akita11/BLE_PresenPointer/README.md

# BLEプレゼンポインター 関連ファイル

by akita11(akita@ifdl.jp)

## ファイル・フォルダ構成

* board: 基板データ
* src: ソースコード(PSoC Creator4.0用: TPT02rを使ってください)
* BLE_PresenterModule_v150.pdf (組み立て手順、使い方）
* BLE_PresenterModule_v150_digest.pdf (マニュアル要約：製品同梱）
