akita11/BLE_PresenPointer/board/BLE_PP_v16_BOM.xlsx

BOM for TPT02
Elecrow PN | Parts | Value | Package | QTY | Digikey/Mouser/Manufacturer Part | Remark/ Link
2014210A | C1,C2 | 10u | C0603 | 2
4040806A | D1 | LED, blue | C0603 | 1
 | L1 | 4.7uH | C2016 | 1 | 732-2956-1-ND | Wurth, 74479776247
C22775 | R1 | 100ohm | C0603 | 1
C23150 | R2 | 390kohm | C0603 | 1
C25803 | R3 | 100kohm | C0603 | 1
 | SW1 | EVQ-P2T02W |  | 1 | P11083SCT-ND | Panasonic, EVQ-P2T02W
 | SW2,SW3 | EVQ-PLFA08 |  | 2 | P12275SCT-ND | Panasonic, EVQ-PLFA08
 | SW4 | CUS-12TB |  | 1 | 563-1102-1-ND | Copal, CUS-12TB
 | SW5 | EVQP7A01P |  | 1 | P16763CT-ND | Panasonic, EVQP7A01P
 | U1 | CYBLE-014008-00 |  | 1 | 428-3600-1-ND | Cypress, CYBLE-014008-00
 | U2 | TPS61221DCKR |  | 1 | 296-41854-1-ND | TI, TPS61221DCKR
