akita11/BLE_PresenPointer/board/work/TPT02_v12_BOM.xlsx

BOM Example
Elecrow PN | Parts | Value | Package | QTY | Digikey/Mouser/Manufacturer Part | Remark/ Link
2014210A | C1,C2 | 10u | C0603 | 2
4040806A | D1 | LED, blue | C0603 | 1
 | L1 | 4.7uF | C2016 | 1 | 732-2954-1-ND | Wurth, 74479776222
1023510A | R1 | 10k | C0603 | 1
 | SW1 | EVQ-P2R02M |  | 1 | P12292SCT-ND | Panasonic, EVQ-P2R02M
 | SW2,SW3 | EVQ-PLFA08 |  | 2 | P12275SCT-ND | Panasonic, EVQ-PLFA08
 | SW4 | CUS-12TB |  | 1 | 563-1102-1-ND | Copal, CUS-12TB
 | SW5 | B3U-3000P |  | 1 | SW1022CT-ND | Omron, B3U-3000P
 | U1 | CYBLE-014008-00 |  | 1 | 428-3600-1-ND | Cypress, CYBLE-014008-00
 | U2 | TPS61221DCKR |  | 1 | 296-41854-1-ND | TI, TPS61221DCKR
