akita11/BLE_PresenPointer/(list of files, cad)

Other CAD files:
board/work/TPT02_v142-tcream.dxf
board/work/TPT02_v14-tcream.dxf
board/work/TPT02_v13-tcream.dxf
