akita11/BLE_PresenPointer/board/work/TPT02_PartsMapping_Component.pdf

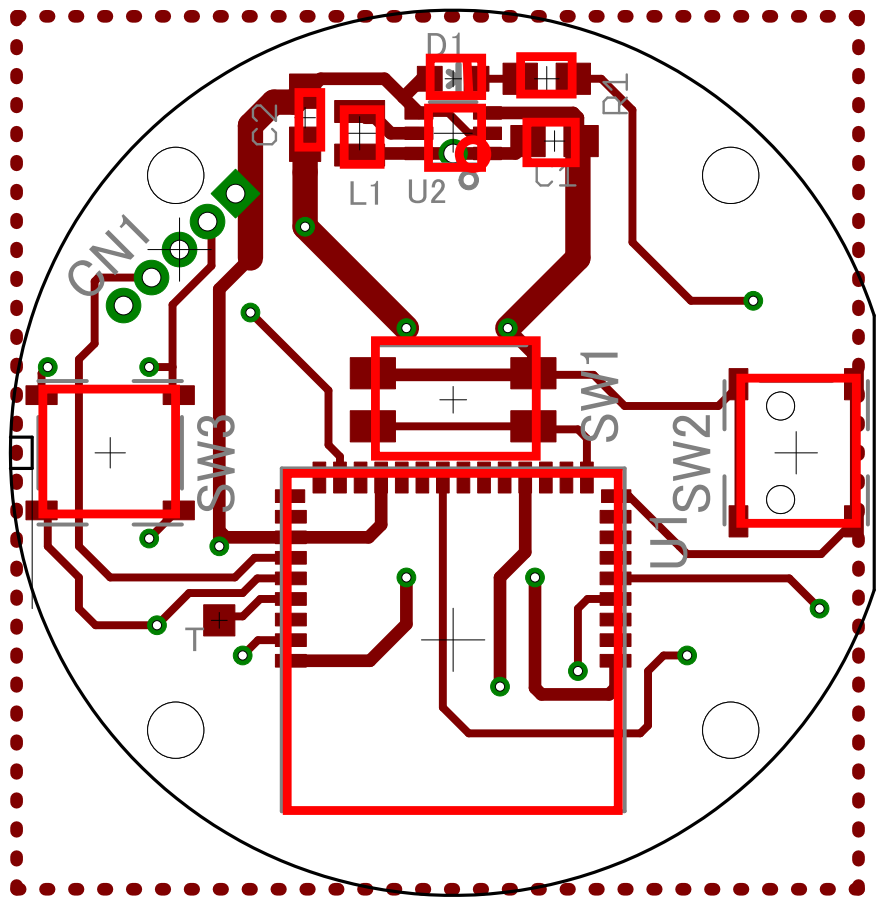
[picture p15: page 1]
