akita11/BLE_PresenPointer/board/work/TPT02_PartsMapping_Solder.pdf

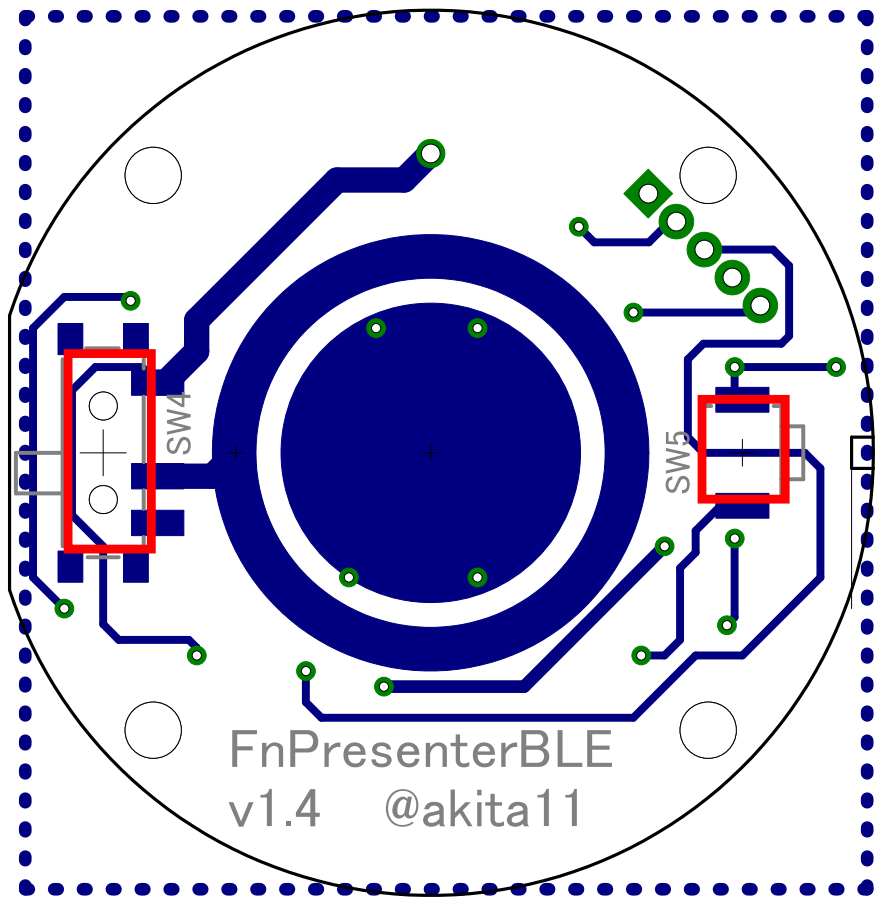
[picture p16: page 1]
