akita11/BLE_PresenPointer/BLE_PresenterModule_v150_digest.pdf

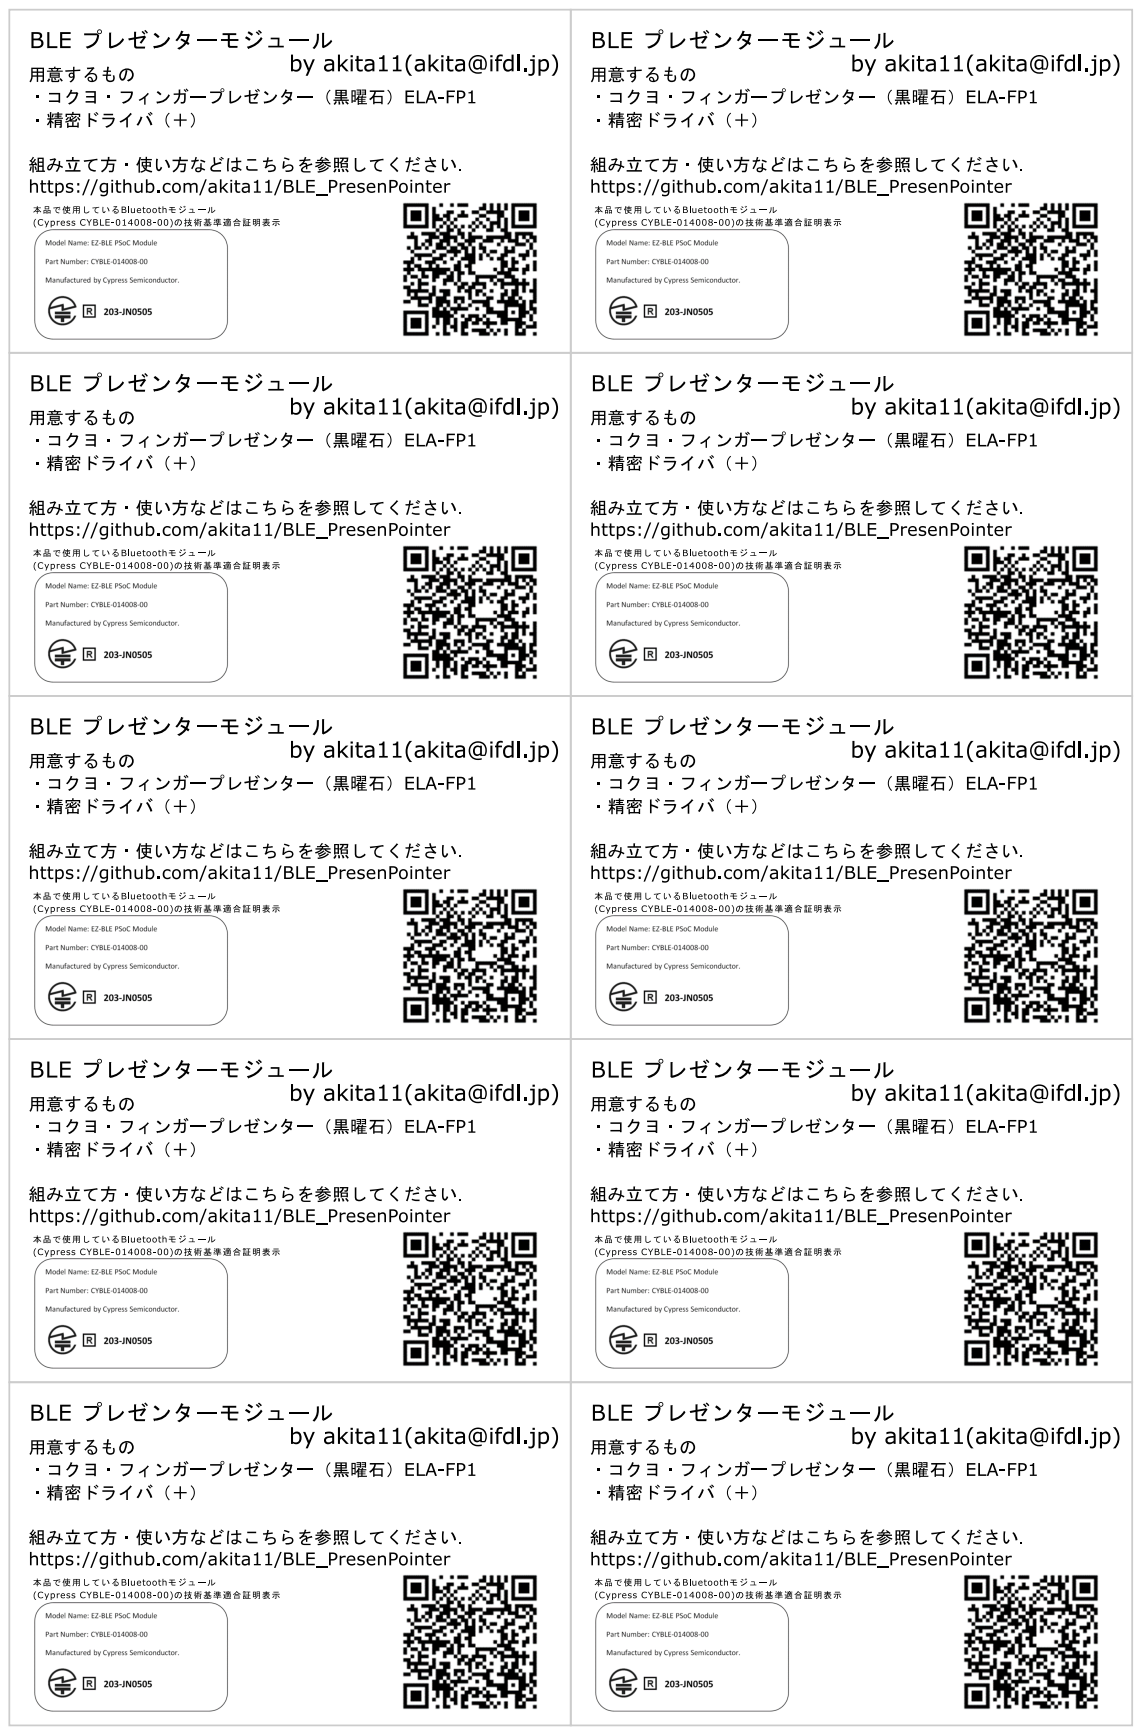
[picture p17: page 1]
