akita11/BLE_PresenPointer/board/BLE_PP_v16.brd

## EAGLE design board/BLE_PP_v16.brd (2017-04-21)

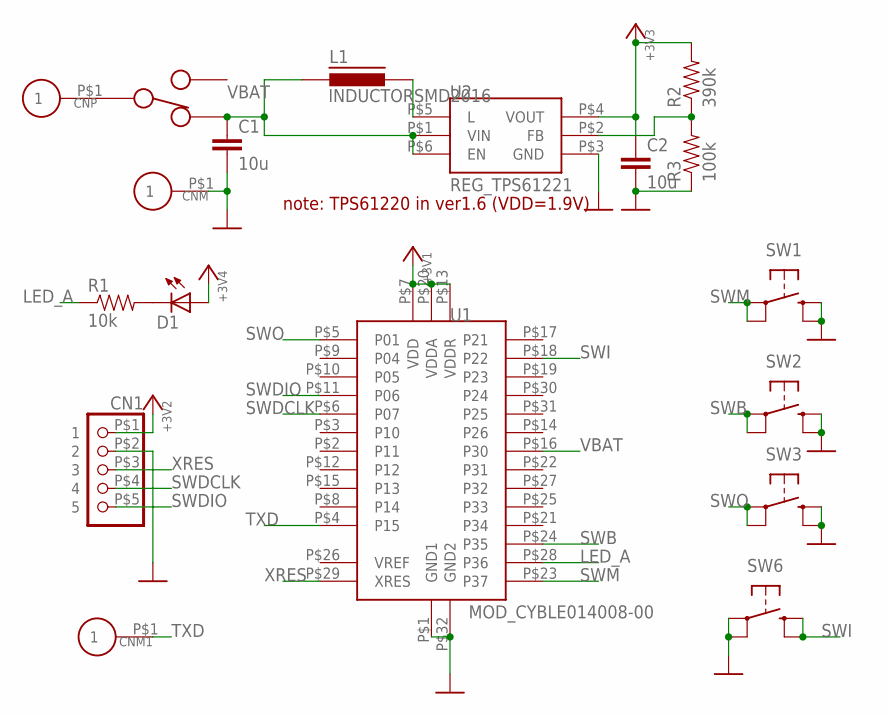
[picture p18: schematic BLE_PP_v16.sch]

Parts:
C1, C2: 10u; 0603
CN1: CON_PINHD-1X550MIL; 1X5_50MIL
CNM, CNM1: CON_P01SMD1MM; PAD_SMD1MM
CNP: CON_P01SMD1MM; PAD_SMD1MM
D1: LED0603; SPARKFUN_LED-0603
L1: INDUCTORSMD2016; 2016
R1: 10k; 0603
R2: 390k; 0603
R3: 100k; 0603
SW1: SW_TACTEVQP2; SW_EVQP2
SW2, SW3: SW_TACTEVQPLNA08NOGND; SW_EVQPLBA08_NOGND
SW4: SW_SLIDECUS12B; SW_CUS-12B
SW6: SW_TACTEVQP7; SW_EVQP7
U1: MOD_CYBLE014008-00
U2: REG_TPS61221; SC70-6

Connections:
+3V3: C2.1, CN1.P$1 (1), D1.A, R2.2, U1.P$7 (VDD), U1.P$13 (VDDR), U1.P$20 (VDDA), U2.P$4 (VOUT)
GND: C1.2, C2.2, CN1.P$2 (2), CNM.P$1, R3.1, SW1.PB1 (S), SW1.PB2 (S1), SW2.B1 (S), SW2.B2 (S1), SW3.B1 (S), SW3.B2 (S1), SW6.P$1A, SW6.P$1B (P1), U1.P$1 (GND1), U1.P$32 (GND2), U2.P$3 (GND)
LED_A: R1.1, U1.P$28 (P36)
unnamed: R2.1, R3.2, U2.P$2 (FB)
unnamed: L1.P$2 (2), U2.P$5 (L)
unnamed: D1.C, R1.2
unnamed: CNP.P$1, SW4.P$2
P$3: SW4.P$3
SWB: SW2.A1, SW2.A2 (P1), U1.P$24 (P35)
SWDCLK: CN1.P$4 (4), U1.P$6 (P07)
SWDIO: CN1.P$5 (5), U1.P$11 (P06)
SWI: SW6.P$2A (S), SW6.P$2B (S1), U1.P$18 (P22)
SWM: SW1.PA1, SW1.PA2 (P1), U1.P$23 (P37)
SWO: SW3.A1, SW3.A2 (P1), U1.P$5 (P01)
TXD: CNM1.P$1, U1.P$4 (P15)
VBAT: C1.1, L1.P$1 (1), SW4.P$1, U1.P$16 (P30), U2.P$1 (VIN), U2.P$6 (EN)
XRES: CN1.P$3 (3), U1.P$29 (XRES)

Notes on the sheet:
note: TPS61220 in ver1.6 (VDD=1.9V)

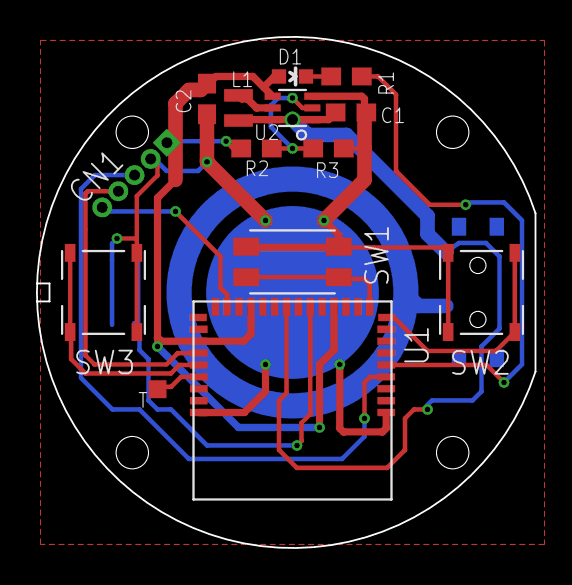
[picture p19: board BLE_PP_v16.brd from above]

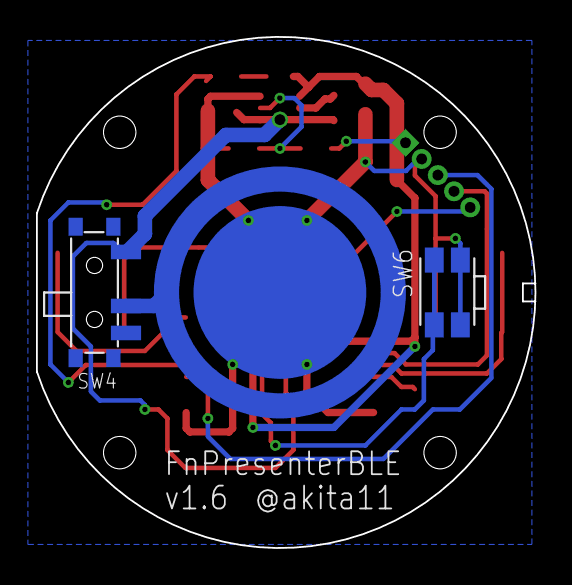
[picture p20: board BLE_PP_v16.brd from below]

Board: 2 copper layers, 27.7 x 28.4 mm, 18 parts (4 on the bottom side), 16 nets.
