akita11/BLE_PresenPointer/board/work/TPT02_tentative.brd

## EAGLE design board/work/TPT02_tentative.brd (2016-12-26)

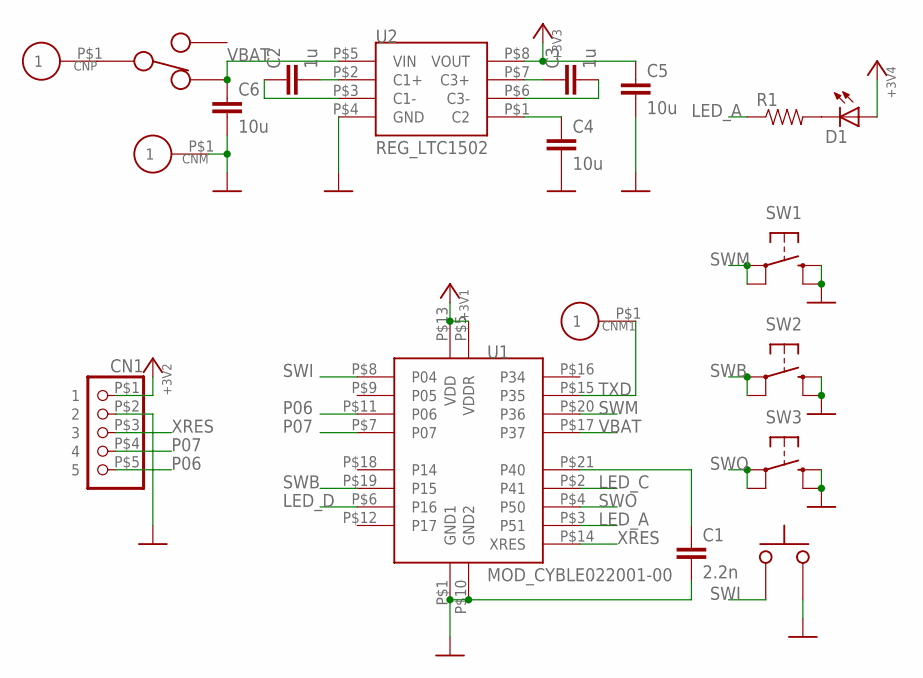
[picture p21: schematic TPT02_tentative.sch]

Parts:
C1: 2.2n; 0603
C2, C3: 1u; 0603
C4, C5, C6: 10u; 0603
CN1: CON_PINHD-1X550MIL; 1X5_50MIL
CNM, CNM1: CON_P01SMD1MM; PAD_SMD1MM
CNP: CON_P01SMD1MM; PAD_SMD1MM
D1: LED0603; SPARKFUN_LED-0603
R1: RES0603; 0603
SW1: SW_TACTEVQP2; SW_EVQP2
SW2, SW3: SW_TACTTVAF17; SW_TVF17
SW4: SW_SLIDECUS12; SW_CUS-12B
SW6: SW_TACT2PB3U3000; SW_B3U-3000P
U1: MOD_CYBLE022001-00
U2: REG_LTC1502; MSOP8

Connections:
+3V3: C5.1, CN1.P$1 (1), D1.A, U1.P$5 (VDDR), U1.P$13 (VDD), U2.P$8 (VOUT)
GND: C1.2, C4.2, C5.2, C6.2, CN1.P$2 (2), CNM.P$1, SW1.PB1 (S), SW1.PB2 (S1), SW2.P$3 (S), SW2.P$4 (S1), SW3.P$3 (S), SW3.P$4 (S1), SW6.P$1, U1.P$1 (GND1), U1.P$10 (GND2), U2.P$4 (GND)
LED_A: R1.1, U1.P$3 (P51)
LED_C: U1.P$2 (P41)
LED_D: U1.P$6 (P16)
unnamed: C1.1, U1.P$21 (P40)
unnamed: C4.1, U2.P$1 (C2)
unnamed: C2.2, U2.P$2 (C1+)
unnamed: C2.1, U2.P$3 (C1-)
unnamed: C3.1, U2.P$7 (C3+)
unnamed: C3.2, U2.P$6 (C3-)
unnamed: D1.C, R1.2
unnamed: CNP.P$1, SW4.P$2
P06: CN1.P$5 (5), U1.P$11 (P06)
P07: CN1.P$4 (4), U1.P$7 (P07)
P$3: SW4.P$3
SWB: SW2.P$1, SW2.P$2 (P1), U1.P$19 (P15)
SWI: SW6.P$2, U1.P$8 (P04)
SWM: SW1.PA1, SW1.PA2 (P1), U1.P$20 (P36)
SWO: SW3.P$1, SW3.P$2 (P1), U1.P$4 (P50)
TXD: CNM1.P$1, U1.P$15 (P35)
VBAT: C6.1, SW4.P$1, U1.P$17 (P37), U2.P$5 (VIN)
XRES: CN1.P$3 (3), U1.P$14 (XRES)

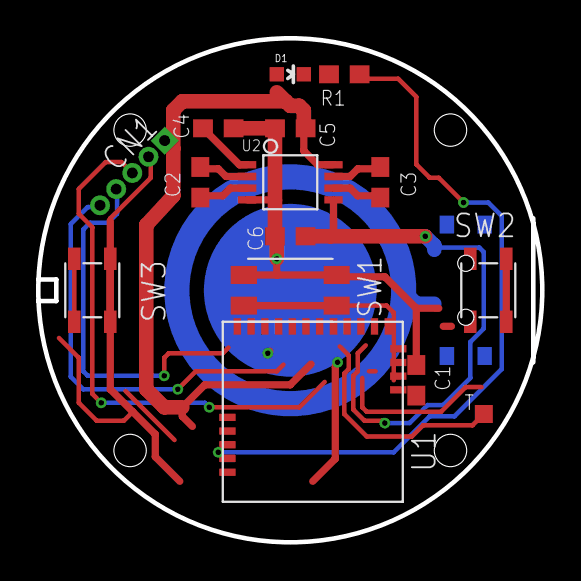
[picture p22: board TPT02_tentative.brd from above]

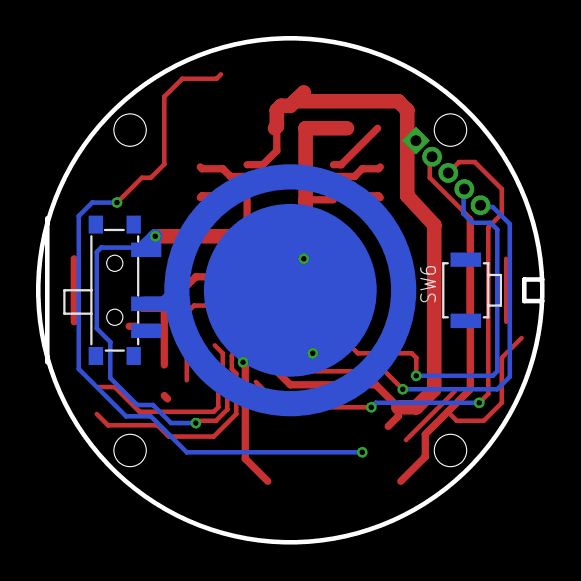
[picture p23: board TPT02_tentative.brd from below]

Board: 2 copper layers, 28.0 x 28.0 mm, 19 parts (4 on the bottom side), 20 nets.
