akita11/BLE_PresenPointer/src/TPT02r.cydsn/main.c

// BLE Presenter Module Firmware v1.5
//   Based on Cypress PSoC Creator (4.0), BLE-HID sample project
//   (c) Junichi Akita (akita@ifdl.jp), 2017/4/20

/*******************************************************************************
* File Name: main.c
*
* Version: 1.0
*
* Description:
*  BLE HID keyboard example project that supports both input and output reports
*  in boot and protocol mode. The example also demonstrates handling suspend 
*  event from the central device and enters low power mode when suspended.
*
* References:
*  BLUETOOTH SPECIFICATION Version 4.1
*  HID Usage Tables spec ver 1.12
*
* Hardware Dependency:
*  CY8CKIT-042 BLE
*
********************************************************************************
* Copyright 2015, Cypress Semiconductor Corporation.  All rights reserved.
* You may use this file only in accordance with the license, terms, conditions,
* disclaimers, and limitations in the end user license agreement accompanying
* the software package with which this file was provided.
*******************************************************************************/

#include "common.h"
#include "hids.h"
#include "bas.h"
#include "scps.h"

volatile uint32 mainTimer = 0;

volatile uint16_t Ton = 0;
volatile uint16_t Tconnect = 0;
uint8_t fUpdated = 0;

CY_ISR(SWID_Handler)
{
    /* Clear pending Interrupt */
    Wakeup_Interrupt_ClearPending();

    /* Clear pin Interrupt */
    SWID_ClearInterrupt();
//    DBG_PRINTF("ID\r\n");
}


/*******************************************************************************
* Function Name: AppCallBack()
********************************************************************************
*
* Summary:
*   This is an event callback function to receive events from the BLE Component.
*
*******************************************************************************/
void AppCallBack(uint32 event, void* eventParam)
{
    CYBLE_API_RESULT_T apiResult;
    CYBLE_GAP_BD_ADDR_T localAddr;
    CYBLE_GAP_AUTH_INFO_T *authInfo;
    uint8 i;
    
    switch (event)
	{
        /**********************************************************
        *                       General Events
        ***********************************************************/
		case CYBLE_EVT_STACK_ON: /* This event is received when the component is Started */
            /* Enter into discoverable mode so that remote can search it. */
            apiResult = CyBle_GappStartAdvertisement(CYBLE_ADVERTISING_FAST);
            if(apiResult != CYBLE_ERROR_OK)
            {
                DBG_PRINTF("StartAdvertisement API Error: %d \r\n", apiResult);
            }
            DBG_PRINTF("Bluetooth On, StartAdvertisement with addr: ");
            localAddr.type = 0u;
            CyBle_GetDeviceAddress(&localAddr);
            for(i = CYBLE_GAP_BD_ADDR_SIZE; i > 0u; i--)
            {
                DBG_PRINTF("%2.2x", localAddr.bdAddr[i-1]);
            }
            DBG_PRINTF("\r\n");
            break;
		case CYBLE_EVT_TIMEOUT: 
            break;
		case CYBLE_EVT_HARDWARE_ERROR:    /* This event indicates that some internal HW error has occurred. */
            DBG_PRINTF("CYBLE_EVT_HARDWARE_ERROR \r\n");
			break;
            
    	/* This event will be triggered by host stack if BLE stack is busy or not busy.
    	 *  Parameter corresponding to this event will be the state of BLE stack.
    	 *  BLE stack busy = CYBLE_STACK_STATE_BUSY,
    	 *  BLE stack not busy = CYBLE_STACK_STATE_FREE 
         */
    	case CYBLE_EVT_STACK_BUSY_STATUS:
            DBG_PRINTF("CYBLE_EVT_STACK_BUSY_STATUS: %x\r\n", *(uint8 *)eventParam);
            break;
        case CYBLE_EVT_HCI_STATUS:
            DBG_PRINTF("CYBLE_EVT_HCI_STATUS: %x \r\n", *(uint8 *)eventParam);
			break;
            
        /**********************************************************
        *                       GAP Events
        ***********************************************************/
        case CYBLE_EVT_GAP_AUTH_REQ:
            DBG_PRINTF("CYBLE_EVT_AUTH_REQ: security=%x, bonding=%x, ekeySize=%x, err=%x \r\n", 
                (*(CYBLE_GAP_AUTH_INFO_T *)eventParam).security, 
                (*(CYBLE_GAP_AUTH_INFO_T *)eventParam).bonding, 
                (*(CYBLE_GAP_AUTH_INFO_T *)eventParam).ekeySize, 
                (*(CYBLE_GAP_AUTH_INFO_T *)eventParam).authErr);
            break;
        case CYBLE_EVT_GAP_PASSKEY_ENTRY_REQUEST:
            DBG_PRINTF("CYBLE_EVT_PASSKEY_ENTRY_REQUEST press 'p' to enter passkey \r\n");
            break;
        case CYBLE_EVT_GAP_PASSKEY_DISPLAY_REQUEST:
            DBG_PRINTF("CYBLE_EVT_PASSKEY_DISPLAY_REQUEST %6.6ld \r\n", *(uint32 *)eventParam);
            break;
        case CYBLE_EVT_GAP_KEYINFO_EXCHNGE_CMPLT:
            DBG_PRINTF("CYBLE_EVT_GAP_KEYINFO_EXCHNGE_CMPLT \r\n");
            break;
        case CYBLE_EVT_GAP_AUTH_COMPLETE:
            authInfo = (CYBLE_GAP_AUTH_INFO_T *)eventParam;
            (void)authInfo;
            DBG_PRINTF("AUTH_COMPLETE: security:%x, bonding:%x, ekeySize:%x, authErr %x \r\n", 
                                    authInfo->security, authInfo->bonding, authInfo->ekeySize, authInfo->authErr);
            break;
        case CYBLE_EVT_GAP_AUTH_FAILED:
            DBG_PRINTF("CYBLE_EVT_AUTH_FAILED: %x \r\n", *(uint8 *)eventParam);
            break;
        case CYBLE_EVT_GAPP_ADVERTISEMENT_START_STOP:
            DBG_PRINTF("CYBLE_EVT_ADVERTISING, state: %x \r\n", CyBle_GetState());
            if(CYBLE_STATE_DISCONNECTED == CyBle_GetState())
            {   
                /* Fast and slow advertising period complete, go to low power  
                 * mode (Hibernate mode) and wait for an external
                 * user event to wake up the device again */
                DBG_PRINTF("Hibernate \r\n");
                Advertising_LED_Write(LED_OFF);
//                Disconnect_LED_Write(LED_ON);
                CapsLock_LED_Write(LED_OFF);
//                SW2_ClearInterrupt();
                Wakeup_Interrupt_ClearPending();
                Wakeup_Interrupt_Start();
            #if (DEBUG_UART_ENABLED == ENABLED)
                /* Wait until debug info is sent */
                while((UART_DEB_SpiUartGetTxBufferSize() + UART_DEB_GET_TX_FIFO_SR_VALID) != 0);
            #endif /* (DEBUG_UART_ENABLED == ENABLED) */
                CySysPmHibernate();
            }
            break;
        case CYBLE_EVT_GAP_DEVICE_CONNECTED:
            DBG_PRINTF("CYBLE_EVT_GAP_DEVICE_CONNECTED \r\n");
            int i;
            for (i = 0; i < 5; i++){
                Advertising_LED_Write(LED_ON);
                CyDelay(100);
                Advertising_LED_Write(LED_OFF);
                CyDelay(100);
            }
            Advertising_LED_Write(LED_OFF);
            break;
        case CYBLE_EVT_GAP_DEVICE_DISCONNECTED:
            DBG_PRINTF("CYBLE_EVT_GAP_DEVICE_DISCONNECTED\r\n");
            apiResult = CyBle_GappStartAdvertisement(CYBLE_ADVERTISING_FAST);
            if(apiResult != CYBLE_ERROR_OK)
            {
                DBG_PRINTF("StartAdvertisement API Error: %d \r\n", apiResult);
            }
            break;
        case CYBLE_EVT_GATTS_XCNHG_MTU_REQ:
            { 
                uint16 mtu;
                CyBle_GattGetMtuSize(&mtu);
                DBG_PRINTF("CYBLE_EVT_GATTS_XCNHG_MTU_REQ, final mtu= %d \r\n", mtu);
            }
            break;
        case CYBLE_EVT_GATTS_WRITE_REQ:
            DBG_PRINTF("CYBLE_EVT_GATT_WRITE_REQ: %x = ",((CYBLE_GATTS_WRITE_REQ_PARAM_T *)eventParam)->handleValPair.attrHandle);
            ShowValue(&((CYBLE_GATTS_WRITE_REQ_PARAM_T *)eventParam)->handleValPair.value);
            (void)CyBle_GattsWriteRsp(((CYBLE_GATTS_WRITE_REQ_PARAM_T *)eventParam)->connHandle);
            break;
        case CYBLE_EVT_GAP_ENCRYPT_CHANGE:
            DBG_PRINTF("CYBLE_EVT_GAP_ENCRYPT_CHANGE: %x \r\n", *(uint8 *)eventParam);
            break;
        case CYBLE_EVT_GAPC_CONNECTION_UPDATE_COMPLETE:
            DBG_PRINTF("CYBLE_EVT_CONNECTION_UPDATE_COMPLETE: %x \r\n", *(uint8 *)eventParam);
            break;
            
        /**********************************************************
        *                       GATT Events
        ***********************************************************/
        case CYBLE_EVT_GATT_CONNECT_IND:
            DBG_PRINTF("CYBLE_EVT_GATT_CONNECT_IND: %x, %x \r\n", cyBle_connHandle.attId, cyBle_connHandle.bdHandle);
            /* Register service specific callback functions */
            HidsInit();
            BasInit();
            ScpsInit();
            break;
        case CYBLE_EVT_GATT_DISCONNECT_IND:
            DBG_PRINTF("CYBLE_EVT_GATT_DISCONNECT_IND \r\n");
            fUpdated = 0;
            Tconnect = 0;
            Ton = 0;
            break;
        case CYBLE_EVT_GATTS_READ_CHAR_VAL_ACCESS_REQ:
            /* Triggered on server side when client sends read request and when
            * characteristic has CYBLE_GATT_DB_ATTR_CHAR_VAL_RD_EVENT property set.
            * This event could be ignored by application unless it need to response
            * by error response which needs to be set in gattErrorCode field of
            * event parameter. */
            DBG_PRINTF("CYBLE_EVT_GATTS_READ_CHAR_VAL_ACCESS_REQ: handle: %x \r\n", 
                ((CYBLE_GATTS_CHAR_VAL_READ_REQ_T *)eventParam)->attrHandle);
            break;
            
        /**********************************************************
        *                       Other Events
        ***********************************************************/
		case CYBLE_EVT_PENDING_FLASH_WRITE:
            /* Inform application that flash write is pending. Stack internal data 
            * structures are modified and require to be stored in Flash using 
            * CyBle_StoreBondingData() */
            DBG_PRINTF("CYBLE_EVT_PENDING_FLASH_WRITE\r\n");
            break;

        default:
            DBG_PRINTF("OTHER event: %lx \r\n", event);
			break;
	}

}

/*******************************************************************************
* Function Name: Timer_Interrupt
********************************************************************************
*
* Summary:
*  Handles the Interrupt Service Routine for the WDT timer.
*
*******************************************************************************/
CY_ISR(Timer_Interrupt)
{
    if(CySysWdtGetInterruptSource() & WDT_INTERRUPT_SOURCE)
    {
        static uint8 led = LED_OFF;
        static uint32 ledTimer = LED_TIMEOUT;
    
        /* Blink green LED to indicate that device advertises */
        if(CyBle_GetState() == CYBLE_STATE_ADVERTISING)
        {
            if(--ledTimer == 0u) 
            {
                ledTimer = LED_TIMEOUT;
                led ^= LED_OFF;
                Advertising_LED_Write(led);
            }
        }
        
        /* Indicate that timer is raised to the main loop */
        mainTimer++;
        
        /* Clears interrupt request  */
        CySysWdtClearInterrupt(WDT_INTERRUPT_SOURCE);
    }
    Ton++;
    if ((Ton % 10) == 0){
        if (CyBle_GetState() == CYBLE_STATE_CONNECTED)
        {
            Tconnect++;
        }
        DBG_PRINTF("%d %d %d\r\n", Ton, Tconnect, fUpdated);
    }
}

/*******************************************************************************
* Function Name: WDT_Start
********************************************************************************
*
* Summary:
*  Configures WDT to trigger an interrupt.
*
*******************************************************************************/

void WDT_Start(void)
{
    /* Unlock the WDT registers for modification */
    CySysWdtUnlock(); 
    /* Setup ISR */
    WDT_Interrupt_StartEx(&Timer_Interrupt);
    /* Write the mode to generate interrupt on match */
    CySysWdtWriteMode(WDT_COUNTER, CY_SYS_WDT_MODE_INT);
    /* Configure the WDT counter clear on a match setting */
    CySysWdtWriteClearOnMatch(WDT_COUNTER, WDT_COUNTER_ENABLE);
    /* Configure the WDT counter match comparison value */
    CySysWdtWriteMatch(WDT_COUNTER, WDT_TIMEOUT);
    /* Reset WDT counter */
    CySysWdtResetCounters(WDT_COUNTER);
    /* Enable the specified WDT counter */
    CySysWdtEnable(WDT_COUNTER_MASK);
    /* Lock out configuration changes to the Watchdog timer registers */
    CySysWdtLock();    
}


/*******************************************************************************
* Function Name: WDT_Stop
********************************************************************************
*
* Summary:
*  This API stops the WDT timer.
*
*******************************************************************************/
void WDT_Stop(void)
{
    /* Unlock the WDT registers for modification */
    CySysWdtUnlock(); 
    /* Disable the specified WDT counter */
    CySysWdtDisable(WDT_COUNTER_MASK);
    /* Locks out configuration changes to the Watchdog timer registers */
    CySysWdtLock();    
}

/*******************************************************************************
* Function Name: LowPowerImplementation()
********************************************************************************
* Summary:
* Implements low power in the project.
*
* Parameters:
* None
*
* Return:
* None
*
* Theory:
* The function tries to enter deep sleep as much as possible - whenever the 
* BLE is idle and the UART transmission/reception is not happening. At all other
* times, the function tries to enter CPU sleep.
*
*******************************************************************************/
static void LowPowerImplementation(void)
{
    CYBLE_LP_MODE_T bleMode;
    uint8 interruptStatus;
    
    /* For advertising and connected states, implement deep sleep 
     * functionality to achieve low power in the system. For more details
     * on the low power implementation, refer to the Low Power Application 
     * Note.
     */
    if((CyBle_GetState() == CYBLE_STATE_ADVERTISING) || 
       (CyBle_GetState() == CYBLE_STATE_CONNECTED))
    {
        /* Request BLE subsystem to enter into Deep-Sleep mode between connection and advertising intervals */
        bleMode = CyBle_EnterLPM(CYBLE_BLESS_DEEPSLEEP);
        /* Disable global interrupts */
        interruptStatus = CyEnterCriticalSection();
        /* When BLE subsystem has been put into Deep-Sleep mode */
        if(bleMode == CYBLE_BLESS_DEEPSLEEP)
        {
            /* And it is still there or ECO is on */
            if((CyBle_GetBleSsState() == CYBLE_BLESS_STATE_ECO_ON) || 
               (CyBle_GetBleSsState() == CYBLE_BLESS_STATE_DEEPSLEEP))
            {
            #if (DEBUG_UART_ENABLED == ENABLED)
                /* Put the CPU into the Deep-Sleep mode when all debug information has been sent */
                if((UART_DEB_SpiUartGetTxBufferSize() + UART_DEB_GET_TX_FIFO_SR_VALID) == 0u)
                {
                    CySysPmDeepSleep();
                }
                else /* Put the CPU into Sleep mode and let SCB to continue sending debug data */
                {
                    CySysPmSleep();
                }
            #else
                CySysPmDeepSleep();
            #endif /* (DEBUG_UART_ENABLED == ENABLED) */
            }
        }
        else /* When BLE subsystem has been put into Sleep mode or is active */
        {
            /* And hardware doesn't finish Tx/Rx opeation - put the CPU into Sleep mode */
            if(CyBle_GetBleSsState() != CYBLE_BLESS_STATE_EVENT_CLOSE)
            {
                CySysPmSleep();
            }
        }
        /* Enable global interrupt */
        CyExitCriticalSection(interruptStatus);
    }
}


/*******************************************************************************
* Function Name: main()
********************************************************************************
* Summary:
*  Main function for the project.
*
* Parameters:
*  None
*
* Return:
*  None
*
* Theory:
*  The function starts BLE and UART components.
*  This function process all BLE events and also implements the low power 
*  functionality.
*
*******************************************************************************/
int main()
{
    Wakeup_Interrupt_StartEx(SWID_Handler);
    CyGlobalIntEnable;  

#if (DEBUG_UART_ENABLED == ENABLED)
    UART_DEB_Start();
#endif /* (DEBUG_UART_ENABLED == ENABLED) */
    DBG_PRINTF("BLE Presenter v1.6E\r\n");

    Disconnect_LED_Write(LED_OFF);
    Advertising_LED_Write(LED_OFF);
    CapsLock_LED_Write(LED_OFF);

    /* Start CYBLE component and register generic event handler */
    CyBle_Start(AppCallBack);
    WDT_Start();

#if (BAS_MEASURE_ENABLE != 0)
    ADC_Start();
#endif /* BAS_MEASURE_ENABLE != 0 */

    while(1) 
    {           
//        if ((Ton % 10) == 0)DBG_PRINTF("Ton=%d / %d\r\n", Ton, 10*60*30);
        if ((Tconnect == 0 && Ton > 10 * 60 * 2) // 2 min before connection
        || (Tconnect > 0 && Ton > 10 * 60 * 30)){ // 30 min
            DBG_PRINTF("going to shutdown");
            int i;
            for (i = 0; i < 10; i++){
                Advertising_LED_Write(0);
                CyDelay(10);
                Advertising_LED_Write(1);
                CyDelay(10);
            }
            CySysPmHibernate();
            DBG_PRINTF("done");
            Ton = 0;
        }
        
//        DBG_PRINTF("1");
        if ((Tconnect > 10 && fUpdated == 0) || (Tconnect > 60 && fUpdated == 2))
        {
            DBG_PRINTF("sending L2CAP connectup update request...\r\n");
            CYBLE_GAP_CONN_UPDATE_PARAM_T connUpdateParam;
            connUpdateParam.connIntvMin = CYBLE_GAPP_CONNECTION_INTERVAL_MIN;
            connUpdateParam.connIntvMax = CYBLE_GAPP_CONNECTION_INTERVAL_MAX;
            connUpdateParam.connLatency = CYBLE_GAPP_CONNECTION_SLAVE_LATENCY;
            connUpdateParam.supervisionTO = CYBLE_GAPP_CONNECTION_TIME_OUT;
            CYBLE_API_RESULT_T apiResult;
            apiResult = CyBle_L2capLeConnectionParamUpdateRequest(cyBle_connHandle.bdHandle, &connUpdateParam);
            if(apiResult == CYBLE_ERROR_OK)
            {
                DBG_PRINTF("CyBle_L2capLeConnectionParamUpdateRequest OK\r\n");
            }
            else
            {
                DBG_PRINTF("CyBle_L2capLeConnectionParamUpdateRequest API Error: %x \r\n", apiResult);
            }
            fUpdated++;
            Tconnect = 1;
        }
        if (fUpdated == 1 && Tconnect == 2) fUpdated = 2;
        else if (fUpdated == 3 && Tconnect == 2) fUpdated = 1;
//        DBG_PRINTF("2");
        /* CyBle_ProcessEvents() allows BLE stack to process pending events */
        CyBle_ProcessEvents();
//        DBG_PRINTF("3");
        /* To achieve low power in the device */
        LowPowerImplementation();
//        DBG_PRINTF("4");
        if((CyBle_GetState() == CYBLE_STATE_CONNECTED) && (suspend != CYBLE_HIDS_CP_SUSPEND))
        {            
            
            if(mainTimer != 0u)
            {
                mainTimer = 0u;                
            #if (BAS_SIMULATE_ENABLE != 0)
                SimulateBattery();
                CyBle_ProcessEvents();
            #endif /* BAS_SIMULATE_ENABLE != 0 */    
            #if (BAS_MEASURE_ENABLE != 0)
                MeasureBattery();
                CyBle_ProcessEvents();
            #endif /* BAS_MEASURE_ENABLE != 0 */
                if(keyboardSimulation == ENABLED)
                {
                    SimulateKeyboard();
                }
            }
            /* Store bonding data to flash only when all debug information has been sent */
        #if(CYBLE_BONDING_REQUIREMENT == CYBLE_BONDING_YES)
        #if (DEBUG_UART_ENABLED == ENABLED)
            if((cyBle_pendingFlashWrite != 0u) &&
               ((UART_DEB_SpiUartGetTxBufferSize() + UART_DEB_GET_TX_FIFO_SR_VALID) == 0u))
            
        #else
            if(cyBle_pendingFlashWrite != 0u)
        #endif /* (DEBUG_UART_ENABLED == ENABLED) */
            {
                CYBLE_API_RESULT_T apiResult;
                
                apiResult = CyBle_StoreBondingData(0u);
                (void)apiResult;
                DBG_PRINTF("Store bonding data, status: %x \r\n", apiResult);
            }
        #endif /* CYBLE_BONDING_REQUIREMENT == CYBLE_BONDING_YES */    
        }
//        DBG_PRINTF("5\r\n");
	}   
}  


/* [] END OF FILE */
