akita11/BLE_PresenPointer/src/TPT02r.cydsn/codegentemp/ADC.h

/*******************************************************************************
* File Name: ADC.h
* Version 2.40
*
* Description:
*  This file contains the function prototypes and constants used in
*  the Sequencing Successive Approximation ADC Component.
*
* Note:
*
********************************************************************************
* Copyright 2008-2015, Cypress Semiconductor Corporation.  All rights reserved.
* You may use this file only in accordance with the license, terms, conditions,
* disclaimers, and limitations in the end user license agreement accompanying
* the software package with which this file was provided.
*******************************************************************************/

#if !defined(CY_ADC_SAR_SEQ_ADC_H)
#define CY_ADC_SAR_SEQ_ADC_H

#include "cytypes.h"
#include "CyLib.h"


/***************************************
*      Data Struct Definition
***************************************/

/* Sleep Mode API Support */
typedef struct
{
    uint8 enableState;
} ADC_BACKUP_STRUCT;


/**************************************
*    Enumerated Types and Parameters
**************************************/

/*  Clock Source setting constants */
#define ADC__EXTERNAL 0
#define ADC__INTERNAL 1

/*  Sample Mode setting constants */
#define ADC__FREERUNNING 0
#define ADC__HARDWARESOC 1

/*  Reference type setting constants */
#define ADC__VDDA_2 0
#define ADC__VDDA 1
#define ADC__INTERNAL1024 2
#define ADC__INTERNAL1024BYPASSED 3
#define ADC__INTERNALVREF 4
#define ADC__INTERNALVREFBYPASSED 5
#define ADC__VDDA_2BYPASSED 6
#define ADC__EXTERNALVREF 7

/* Input buffer gain setting constants */
#define ADC__DISABLED 0
#define ADC__ONE 1
#define ADC__TWO 2
#define ADC__FOUR 3
#define ADC__EIGHT 4
#define ADC__SIXTEEN 5

/* Negative input setting sonstants in single ended mode */
#define ADC__VSS 0
#define ADC__VREF 1
#define ADC__OTHER 2

/* Compare mode setting constants:
*    Mode0 - Disable
*    Mode1 - Result < Low_Limit
*    Mode2 - Low_Limit <= Result < High_Limit
*    Mode3 - High_Limit <= Result
*    Mode4 - (Result < Low_Limit) or (High_Limit <= Result)
*/
#define ADC__MODE0 0
#define ADC__MODE1 1
#define ADC__MODE2 2
#define ADC__MODE3 3

#define ADC__RES8 0
#define ADC__RES10 1

#define ADC__RIGHT 0
#define ADC__LEFT 1

#define ADC__FSIGNED 1
#define ADC__FUNSIGNED 0

#define ADC__ACCUMULATE 0
#define ADC__FIXEDRESOLUTION 1



/***************************************
*   Conditional Compilation Parameters
****************************************/ 

#define ADC_CY_SAR_IP_VER0               	(0u)
#define ADC_CY_SAR_IP_VER1               	(1u)

#if (CY_PSOC4_4100 || CY_PSOC4_4200)
    #define ADC_CY_SAR_IP_VER              (ADC_CY_SAR_IP_VER0)
#else /* Other devices */
    #define ADC_CY_SAR_IP_VER              (ADC_CY_SAR_IP_VER1)
#endif  /* (CY_PSOC4_4100 || CY_PSOC4_4200) */


/***************************************
*    Initial Parameter Constants
***************************************/
#define ADC_DEFAULT_SAMPLE_MODE_SEL        (1u)
#define ADC_DEFAULT_VREF_SEL               (1u)
#define ADC_DEFAULT_NEG_INPUT_SEL          (0u)
#define ADC_DEFAULT_ALT_RESOLUTION_SEL     (0u)
#define ADC_DEFAULT_JUSTIFICATION_SEL      (0u)
#define ADC_DEFAULT_DIFF_RESULT_FORMAT_SEL (0u)
#define ADC_DEFAULT_SE_RESULT_FORMAT_SEL   (1u)
#define ADC_DEFAULT_CLOCK_SOURCE           (1u)
#define ADC_DEFAULT_VREF_MV_VALUE          (3300)
#define ADC_DEFAULT_BUFFER_GAIN            (0u)
#define ADC_DEFAULT_AVG_SAMPLES_NUM        (4u)
#define ADC_DEFAULT_AVG_SAMPLES_DIV        (int16)(0x100u >> (7u - 4u))
#define ADC_DEFAULT_AVG_MODE               (1u)
#define ADC_MAX_RESOLUTION                 (12u)
#define ADC_DEFAULT_LOW_LIMIT              (0u)
#define ADC_DEFAULT_HIGH_LIMIT             (2047u)
#define ADC_DEFAULT_COMPARE_MODE           (0u)
#define ADC_DEFAULT_ACLKS_NUM              (4u)
#define ADC_DEFAULT_BCLKS_NUM              (4u)
#define ADC_DEFAULT_CCLKS_NUM              (4u)
#define ADC_DEFAULT_DCLKS_NUM              (4u)
#define ADC_TOTAL_CHANNELS_NUM             (1u)
#define ADC_SEQUENCED_CHANNELS_NUM         (1u)
#define ADC_DEFAULT_EN_CHANNELS            (1u)
#define ADC_NOMINAL_CLOCK_FREQ             (1600000)
#define ADC_INJ_CHANNEL_ENABLED            (0u)
#define ADC_IRQ_REMOVE                     (0u)

/* Determines whether the configuration contains external negative input. */
#define ADC_SINGLE_PRESENT                 (0u)
#define ADC_CHANNELS_MODE                  (0u)
#define ADC_MAX_CHANNELS_EN_MASK           (0xffffu >> (16u - ADC_SEQUENCED_CHANNELS_NUM))


/***************************************
*        Function Prototypes
***************************************/

void ADC_Start(void);
void ADC_Stop(void);
void ADC_Init(void);
void ADC_Enable(void);
void ADC_StartConvert(void);
void ADC_StopConvert(void);
uint32 ADC_IsEndConversion(uint32 retMode);
int16 ADC_GetResult16(uint32 chan);
void ADC_SetChanMask(uint32 mask);
void ADC_SetLowLimit(uint32 lowLimit);
void ADC_SetHighLimit(uint32 highLimit);
void ADC_SetLimitMask(uint32 mask);
void ADC_SetSatMask(uint32 mask);
void ADC_SetOffset(uint32 chan, int16 offset);
void ADC_SetGain(uint32 chan, int32 adcGain);
#if(ADC_INJ_CHANNEL_ENABLED)
    void ADC_EnableInjection(void);
#endif /* ADC_INJ_CHANNEL_ENABLED */
#if(ADC_DEFAULT_JUSTIFICATION_SEL == ADC__RIGHT)
    int16 ADC_CountsTo_mVolts(uint32 chan, int16 adcCounts);
    int32 ADC_CountsTo_uVolts(uint32 chan, int16 adcCounts);
    float32 ADC_CountsTo_Volts(uint32 chan, int16 adcCounts);
#endif /* End ADC_DEFAULT_JUSTIFICATION_SEL == ADC__RIGHT */
void ADC_Sleep(void);
void ADC_Wakeup(void);
void ADC_SaveConfig(void);
void ADC_RestoreConfig(void);

CY_ISR_PROTO( ADC_ISR );


/**************************************
*           API Constants
**************************************/
/* Constants for Sleep mode states */
#define ADC_DISABLED                   (0x00u)
#define ADC_ENABLED                    (0x01u)
#define ADC_STARTED                    (0x02u)
#define ADC_BOOSTPUMP_ENABLED          (0x04u)

/*   Constants for IsEndConversion() "retMode" parameter  */
#define ADC_RETURN_STATUS              (0x01u)
#define ADC_WAIT_FOR_RESULT            (0x02u)
#define ADC_RETURN_STATUS_INJ          (0x04u)
#define ADC_WAIT_FOR_RESULT_INJ        (0x08u)

#define ADC_MAX_FREQUENCY              (18000000)       /*18Mhz*/

#define ADC_RESOLUTION_12              (12u)
#define ADC_RESOLUTION_10              (10u)
#define ADC_RESOLUTION_8               (8u)

#define ADC_10US_DELAY                 (10u)

#define ADC_10V_COUNTS                 (10.0F)
#define ADC_10MV_COUNTS                (10000)
#define ADC_10UV_COUNTS                (10000000L)


/***************************************
* Global variables external identifier
***************************************/

extern uint8 ADC_initVar;
extern volatile int16 ADC_offset[ADC_TOTAL_CHANNELS_NUM];
extern volatile int32 ADC_countsPer10Volt[ADC_TOTAL_CHANNELS_NUM];


/***************************************
*              Registers
***************************************/

#define ADC_SAR_CTRL_REG                (*(reg32 *) ADC_cy_psoc4_sar__SAR_CTRL )
#define ADC_SAR_CTRL_PTR                ( (reg32 *) ADC_cy_psoc4_sar__SAR_CTRL )

#define ADC_SAR_SAMPLE_CTRL_REG         (*(reg32 *) ADC_cy_psoc4_sar__SAR_SAMPLE_CTRL )
#define ADC_SAR_SAMPLE_CTRL_PTR         ( (reg32 *) ADC_cy_psoc4_sar__SAR_SAMPLE_CTRL )

#define ADC_SAR_SAMPLE_TIME01_REG       (*(reg32 *) ADC_cy_psoc4_sar__SAR_SAMPLE_TIME01 )
#define ADC_SAR_SAMPLE_TIME01_PTR       ( (reg32 *) ADC_cy_psoc4_sar__SAR_SAMPLE_TIME01 )

#define ADC_SAR_SAMPLE_TIME23_REG       (*(reg32 *) ADC_cy_psoc4_sar__SAR_SAMPLE_TIME23 )
#define ADC_SAR_SAMPLE_TIME23_PTR       ( (reg32 *) ADC_cy_psoc4_sar__SAR_SAMPLE_TIME23 )

#define ADC_SAR_RANGE_THRES_REG         (*(reg32 *) ADC_cy_psoc4_sar__SAR_RANGE_THRES )
#define ADC_SAR_RANGE_THRES_PTR         ( (reg32 *) ADC_cy_psoc4_sar__SAR_RANGE_THRES )

#define ADC_SAR_RANGE_COND_REG          (*(reg32 *) ADC_cy_psoc4_sar__SAR_RANGE_COND )
#define ADC_SAR_RANGE_COND_PTR          ( (reg32 *) ADC_cy_psoc4_sar__SAR_RANGE_COND )

#define ADC_SAR_CHAN_EN_REG             (*(reg32 *) ADC_cy_psoc4_sar__SAR_CHAN_EN )
#define ADC_SAR_CHAN_EN_PTR             ( (reg32 *) ADC_cy_psoc4_sar__SAR_CHAN_EN )

#define ADC_SAR_START_CTRL_REG          (*(reg32 *) ADC_cy_psoc4_sar__SAR_START_CTRL )
#define ADC_SAR_START_CTRL_PTR          ( (reg32 *) ADC_cy_psoc4_sar__SAR_START_CTRL )

#define ADC_SAR_DFT_CTRL_REG            (*(reg32 *) ADC_cy_psoc4_sar__SAR_DFT_CTRL )
#define ADC_SAR_DFT_CTRL_PTR            ( (reg32 *) ADC_cy_psoc4_sar__SAR_DFT_CTRL )

#define ADC_SAR_CHAN_CONFIG_REG         (*(reg32 *) ADC_cy_psoc4_sar__SAR_CHAN_CONFIG00 )
#define ADC_SAR_CHAN_CONFIG_PTR         ( (reg32 *) ADC_cy_psoc4_sar__SAR_CHAN_CONFIG00 )
#define ADC_SAR_CHAN_CONFIG_IND         ADC_cy_psoc4_sar__SAR_CHAN_CONFIG00

#define ADC_SAR_CHAN_WORK_REG           (*(reg32 *) ADC_cy_psoc4_sar__SAR_CHAN_WORK00 )
#define ADC_SAR_CHAN_WORK_PTR           ( (reg32 *) ADC_cy_psoc4_sar__SAR_CHAN_WORK00 )

#define ADC_SAR_CHAN_RESULT_REG         (*(reg32 *) ADC_cy_psoc4_sar__SAR_CHAN_RESULT00 )
#define ADC_SAR_CHAN_RESULT_PTR         ( (reg32 *) ADC_cy_psoc4_sar__SAR_CHAN_RESULT00 )
#define ADC_SAR_CHAN_RESULT_IND         ADC_cy_psoc4_sar__SAR_CHAN_RESULT00

#define ADC_SAR_CHAN0_RESULT_REG         (*(reg32 *) ADC_cy_psoc4_sar__SAR_CHAN_RESULT00 )
#define ADC_SAR_CHAN0_RESULT_PTR         ( (reg32 *) ADC_cy_psoc4_sar__SAR_CHAN_RESULT00 )

#define ADC_SAR_CHAN1_RESULT_REG         (*(reg32 *) ADC_cy_psoc4_sar__SAR_CHAN_RESULT01 )
#define ADC_SAR_CHAN1_RESULT_PTR         ( (reg32 *) ADC_cy_psoc4_sar__SAR_CHAN_RESULT01 )

#define ADC_SAR_CHAN2_RESULT_REG         (*(reg32 *) ADC_cy_psoc4_sar__SAR_CHAN_RESULT02 )
#define ADC_SAR_CHAN2_RESULT_PTR         ( (reg32 *) ADC_cy_psoc4_sar__SAR_CHAN_RESULT02 )

#define ADC_SAR_CHAN3_RESULT_REG         (*(reg32 *) ADC_cy_psoc4_sar__SAR_CHAN_RESULT03 )
#define ADC_SAR_CHAN3_RESULT_PTR         ( (reg32 *) ADC_cy_psoc4_sar__SAR_CHAN_RESULT03 )

#define ADC_SAR_CHAN4_RESULT_REG         (*(reg32 *) ADC_cy_psoc4_sar__SAR_CHAN_RESULT04 )
#define ADC_SAR_CHAN4_RESULT_PTR         ( (reg32 *) ADC_cy_psoc4_sar__SAR_CHAN_RESULT04 )

#define ADC_SAR_CHAN5_RESULT_REG         (*(reg32 *) ADC_cy_psoc4_sar__SAR_CHAN_RESULT05 )
#define ADC_SAR_CHAN5_RESULT_PTR         ( (reg32 *) ADC_cy_psoc4_sar__SAR_CHAN_RESULT05 )

#define ADC_SAR_CHAN6_RESULT_REG         (*(reg32 *) ADC_cy_psoc4_sar__SAR_CHAN_RESULT06 )
#define ADC_SAR_CHAN6_RESULT_PTR         ( (reg32 *) ADC_cy_psoc4_sar__SAR_CHAN_RESULT06 )

#define ADC_SAR_CHAN7_RESULT_REG         (*(reg32 *) ADC_cy_psoc4_sar__SAR_CHAN_RESULT07 )
#define ADC_SAR_CHAN7_RESULT_PTR         ( (reg32 *) ADC_cy_psoc4_sar__SAR_CHAN_RESULT07 )

#if(ADC_CY_SAR_IP_VER != ADC_CY_SAR_IP_VER0)
    #define ADC_SAR_CHAN8_RESULT_REG     (*(reg32 *) ADC_cy_psoc4_sar__SAR_CHAN_RESULT08 )
    #define ADC_SAR_CHAN8_RESULT_PTR     ( (reg32 *) ADC_cy_psoc4_sar__SAR_CHAN_RESULT08 )

    #define ADC_SAR_CHAN9_RESULT_REG     (*(reg32 *) ADC_cy_psoc4_sar__SAR_CHAN_RESULT09 )
    #define ADC_SAR_CHAN9_RESULT_PTR     ( (reg32 *) ADC_cy_psoc4_sar__SAR_CHAN_RESULT09 )

    #define ADC_SAR_CHAN10_RESULT_REG    (*(reg32 *) ADC_cy_psoc4_sar__SAR_CHAN_RESULT10 )
    #define ADC_SAR_CHAN10_RESULT_PTR    ( (reg32 *) ADC_cy_psoc4_sar__SAR_CHAN_RESULT10 )

    #define ADC_SAR_CHAN11_RESULT_REG    (*(reg32 *) ADC_cy_psoc4_sar__SAR_CHAN_RESULT11 )
    #define ADC_SAR_CHAN11_RESULT_PTR    ( (reg32 *) ADC_cy_psoc4_sar__SAR_CHAN_RESULT11 )

    #define ADC_SAR_CHAN12_RESULT_REG    (*(reg32 *) ADC_cy_psoc4_sar__SAR_CHAN_RESULT12 )
    #define ADC_SAR_CHAN12_RESULT_PTR    ( (reg32 *) ADC_cy_psoc4_sar__SAR_CHAN_RESULT12 )

    #define ADC_SAR_CHAN13_RESULT_REG    (*(reg32 *) ADC_cy_psoc4_sar__SAR_CHAN_RESULT13 )
    #define ADC_SAR_CHAN13_RESULT_PTR    ( (reg32 *) ADC_cy_psoc4_sar__SAR_CHAN_RESULT13 )

    #define ADC_SAR_CHAN14_RESULT_REG    (*(reg32 *) ADC_cy_psoc4_sar__SAR_CHAN_RESULT14 )
    #define ADC_SAR_CHAN14_RESULT_PTR    ( (reg32 *) ADC_cy_psoc4_sar__SAR_CHAN_RESULT14 )

    #define ADC_SAR_CHAN15_RESULT_REG    (*(reg32 *) ADC_cy_psoc4_sar__SAR_CHAN_RESULT15 )
    #define ADC_SAR_CHAN15_RESULT_PTR    ( (reg32 *) ADC_cy_psoc4_sar__SAR_CHAN_RESULT15 )
#endif /* (ADC_CY_SAR_IP_VER != ADC_CY_SAR_IP_VER0) */

#define ADC_SAR_CHAN_WORK_VALID_REG     (*(reg32 *) ADC_cy_psoc4_sar__SAR_CHAN_WORK_VALID)
#define ADC_SAR_CHAN_WORK_VALID_PTR     ( (reg32 *) ADC_cy_psoc4_sar__SAR_CHAN_WORK_VALID)

#define ADC_SAR_CHAN_RESULT_VALID_REG  ( *(reg32 *) ADC_cy_psoc4_sar__SAR_CHAN_RESULT_VALID )
#define ADC_SAR_CHAN_RESULT_VALID_PTR  ( (reg32 *) ADC_cy_psoc4_sar__SAR_CHAN_RESULT_VALID )

#define ADC_SAR_STATUS_REG              (*(reg32 *) ADC_cy_psoc4_sar__SAR_STATUS )
#define ADC_SAR_STATUS_PTR              ( (reg32 *) ADC_cy_psoc4_sar__SAR_STATUS )

#define ADC_SAR_AVG_START_REG           (*(reg32 *) ADC_cy_psoc4_sar__SAR_AVG_STAT )
#define ADC_SAR_AVG_START_PTR           ( (reg32 *) ADC_cy_psoc4_sar__SAR_AVG_STAT )

#define ADC_SAR_INTR_REG                (*(reg32 *) ADC_cy_psoc4_sar__SAR_INTR )
#define ADC_SAR_INTR_PTR                ( (reg32 *) ADC_cy_psoc4_sar__SAR_INTR )

#define ADC_SAR_INTR_SET_REG            (*(reg32 *) ADC_cy_psoc4_sar__SAR_INTR_SET )
#define ADC_SAR_INTR_SET_PTR            ( (reg32 *) ADC_cy_psoc4_sar__SAR_INTR_SET )

#define ADC_SAR_INTR_MASK_REG           (*(reg32 *) ADC_cy_psoc4_sar__SAR_INTR_MASK )
#define ADC_SAR_INTR_MASK_PTR           ( (reg32 *) ADC_cy_psoc4_sar__SAR_INTR_MASK )

#define ADC_SAR_INTR_MASKED_REG         (*(reg32 *) ADC_cy_psoc4_sar__SAR_INTR_MASKED )
#define ADC_SAR_INTR_MASKED_PTR         ( (reg32 *) ADC_cy_psoc4_sar__SAR_INTR_MASKED )

#define ADC_SAR_SATURATE_INTR_REG       (*(reg32 *) ADC_cy_psoc4_sar__SAR_SATURATE_INTR )
#define ADC_SAR_SATURATE_INTR_PTR       ( (reg32 *) ADC_cy_psoc4_sar__SAR_SATURATE_INTR )

#define ADC_SAR_SATURATE_INTR_SET_REG   (*(reg32 *) ADC_cy_psoc4_sar__SAR_SATURATE_INTR_SET )
#define ADC_SAR_SATURATE_INTR_SET_PTR   ( (reg32 *) ADC_cy_psoc4_sar__SAR_SATURATE_INTR_SET )

#define ADC_SAR_SATURATE_INTR_MASK_REG (*(reg32 *) ADC_cy_psoc4_sar__SAR_SATURATE_INTR_MASK )
#define ADC_SAR_SATURATE_INTR_MASK_PTR ( (reg32 *) ADC_cy_psoc4_sar__SAR_SATURATE_INTR_MASK )

#define ADC_SAR_SATURATE_INTR_MASKED_REG \
                                                 (*(reg32 *) ADC_cy_psoc4_sar__SAR_SATURATE_INTR_MASKED )
#define ADC_SAR_SATURATE_INTR_MASKED_PTR \
                                                 ( (reg32 *) ADC_cy_psoc4_sar__SAR_SATURATE_INTR_MASKED )

#define ADC_SAR_RANGE_INTR_REG          (*(reg32 *) ADC_cy_psoc4_sar__SAR_RANGE_INTR )
#define ADC_SAR_RANGE_INTR_PTR          ( (reg32 *) ADC_cy_psoc4_sar__SAR_RANGE_INTR )

#define ADC_SAR_RANGE_INTR_SET_REG      (*(reg32 *) ADC_cy_psoc4_sar__SAR_RANGE_INTR_SET )
#define ADC_SAR_RANGE_INTR_SET_PTR      ( (reg32 *) ADC_cy_psoc4_sar__SAR_RANGE_INTR_SET )

#define ADC_SAR_RANGE_INTR_MASK_REG     (*(reg32 *) ADC_cy_psoc4_sar__SAR_RANGE_INTR_MASK )
#define ADC_SAR_RANGE_INTR_MASK_PTR     ( (reg32 *) ADC_cy_psoc4_sar__SAR_RANGE_INTR_MASK )

#define ADC_SAR_RANGE_INTR_MASKED_REG   (*(reg32 *) ADC_cy_psoc4_sar__SAR_RANGE_INTR_MASKED )
#define ADC_SAR_RANGE_INTR_MASKED_PTR   ( (reg32 *) ADC_cy_psoc4_sar__SAR_RANGE_INTR_MASKED )

#define ADC_SAR_INTR_CAUSE_REG          (*(reg32 *) ADC_cy_psoc4_sar__SAR_INTR_CAUSE )
#define ADC_SAR_INTR_CAUSE_PTR          ( (reg32 *) ADC_cy_psoc4_sar__SAR_INTR_CAUSE )

#if(ADC_INJ_CHANNEL_ENABLED)
    #define ADC_SAR_INJ_CHAN_CONFIG_REG \
                                                 (*(reg32 *) ADC_cy_psoc4_sarmux_8__SAR_INJ_CHAN_CONFIG )
    #define ADC_SAR_INJ_CHAN_CONFIG_PTR    \
                                                 ( (reg32 *) ADC_cy_psoc4_sarmux_8__SAR_INJ_CHAN_CONFIG )

    #define ADC_SAR_INJ_RESULT_REG    (*(reg32 *) ADC_cy_psoc4_sarmux_8__SAR_INJ_RESULT )
    #define ADC_SAR_INJ_RESULT_PTR    ( (reg32 *) ADC_cy_psoc4_sarmux_8__SAR_INJ_RESULT )
#endif /* ADC_INJ_CHANNEL_ENABLED */
    
#define ADC_MUX_SWITCH0_REG           (*(reg32 *)  ADC_cy_psoc4_sar__SAR_MUX_SWITCH0 )
#define ADC_MUX_SWITCH0_PTR           ( (reg32 *)  ADC_cy_psoc4_sar__SAR_MUX_SWITCH0 )

#define ADC_MUX_SWITCH_HW_CTRL_REG    (*(reg32 *)  ADC_cy_psoc4_sar__SAR_MUX_SWITCH_HW_CTRL )
#define ADC_MUX_SWITCH_HW_CTRL_PTR    ( (reg32 *)  ADC_cy_psoc4_sar__SAR_MUX_SWITCH_HW_CTRL )

#define ADC_PUMP_CTRL_REG             (*(reg32 *)  ADC_cy_psoc4_sar__SAR_PUMP_CTRL )
#define ADC_PUMP_CTRL_PTR             ( (reg32 *)  ADC_cy_psoc4_sar__SAR_PUMP_CTRL )

#define ADC_ANA_TRIM_REG              (*(reg32 *)  ADC_cy_psoc4_sar__SAR_ANA_TRIM )
#define ADC_ANA_TRIM_PTR              ( (reg32 *)  ADC_cy_psoc4_sar__SAR_ANA_TRIM )

#define ADC_WOUNDING_REG              (*(reg32 *)  ADC_cy_psoc4_sar__SAR_WOUNDING )
#define ADC_WOUNDING_PTR              ( (reg32 *)  ADC_cy_psoc4_sar__SAR_WOUNDING )


/**************************************
*       Register Constants
**************************************/
#define ADC_INTC_NUMBER                (ADC_IRQ__INTC_NUMBER)
#define ADC_INTC_PRIOR_NUMBER          (ADC_IRQ__INTC_PRIOR_NUM)

/* defines for CTRL register */
#define ADC_VREF_INTERNAL1024          (0x00000040Lu)
#define ADC_VREF_EXTERNAL              (0x00000050Lu)
#define ADC_VREF_VDDA_2                (0x00000060Lu)
#define ADC_VREF_VDDA                  (0x00000070Lu)
#define ADC_VREF_INTERNAL1024BYPASSED  (0x000000C0Lu)
#define ADC_VREF_VDDA_2BYPASSED        (0x000000E0Lu)
#define ADC_VREF_INTERNALVREF          (0x00000040Lu)
#define ADC_VREF_INTERNALVREFBYPASSED  (0x000000C0Lu)

#define ADC_NEG_VSSA_KELVIN            (0x00000000Lu)
#define ADC_NEG_VSSA                   (0x00000200Lu)
#define ADC_NEG_VREF                   (0x00000E00Lu)
#if(ADC_TOTAL_CHANNELS_NUM > 1u)
    #define ADC_NEG_OTHER              (uint16)((uint16)ADC_cy_psoc4_sarmux_8__VNEG << 9u)
#else
    #define ADC_NEG_OTHER              (0)
#endif /* ADC_TOTAL_CHANNELS_NUM > 1u */

#define ADC_SAR_HW_CTRL_NEGVREF        (0x00002000Lu)

#define ADC_BOOSTPUMP_EN               (0x00100000Lu)

#define ADC_NORMAL_PWR                 (0x00000000Lu)
#define ADC_HALF_PWR                   (0x01000000Lu)
#define ADC_MORE_PWR                   (0x02000000Lu)
#define ADC_QUARTER_PWR                (0x03000000Lu)
#define ADC_DEEPSLEEP_ON               (0x08000000Lu)

#define ADC_DSI_SYNC_CONFIG            (0x10000000Lu)
#define ADC_DSI_MODE                   (0x20000000Lu)
#define ADC_SWITCH_DISABLE             (0x40000000Lu)
#define ADC_ENABLE                     (0x80000000Lu)

/* defines for STATUS register */
#define ADC_STATUS_BUSY                (0x80000000Lu)

/* defines for SAMPLE_CTRL register */
#define ADC_ALT_RESOLUTION_10BIT       (0x00000001Lu)
#define ADC_ALT_RESOLUTION_8BIT        (0x00000000Lu)

#define ADC_DATA_ALIGN_LEFT            (0x00000002Lu)
#define ADC_DATA_ALIGN_RIGHT           (0x00000000Lu)

#define ADC_SE_SIGNED_RESULT           (0x00000004Lu)
#define ADC_SE_UNSIGNED_RESULT         (0x00000000Lu)

#define ADC_DIFF_SIGNED_RESULT         (0x00000008Lu)
#define ADC_DIFF_UNSIGNED_RESULT       (0x00000000Lu)

#define ADC_AVG_CNT_OFFSET             (4u)
#define ADC_AVG_CNT_MASK               (0x00000070Lu)
#define ADC_AVG_SHIFT                  (0x00000080Lu)

#define ADC_CONTINUOUS_EN              (0x00010000Lu)
#define ADC_DSI_TRIGGER_EN             (0x00020000Lu)
#define ADC_DSI_TRIGGER_LEVEL          (0x00040000Lu)
#define ADC_DSI_SYNC_TRIGGER           (0x00080000Lu)
#define ADC_EOS_DSI_OUT_EN             (0x80000000Lu)

/* defines for SAMPLE_TIME01 / SAMPLE_TIME23 registers */
#define ADC_SAMPLE_TIME13_OFFSET       (16u)
#define ADC_SAMPLE_TIME02_MASK         (0x000003FFLu)
#define ADC_SAMPLE_TIME13_MASK         (0x03FF0000Lu)

/* defines for RANGE_THRES registers */
#define ADC_RANGE_HIGH_OFFSET          (16u)
#define ADC_RANGE_HIGH_MASK            (0xFFFF0000Lu)
#define ADC_RANGE_LOW_MASK             (0x0000FFFFLu)

/* defines for RANGE_COND register */
/* Compare mode setting constants:
*    BELOW   - Result < Low_Limit
*    INSIDE  - Low_Limit <= Result < High_Limit
*    ABOVE   - High_Limit <= Result
*    OUTSIDE - (Result < Low_Limit) or (High_Limit <= Result)
*/
#define ADC_CMP_MODE_BELOW             (0x00000000Lu)
#define ADC_CMP_MODE_INSIDE            (0x40000000Lu)
#define ADC_CMP_MODE_ABOVE             (0x80000000Lu)
#define ADC_CMP_MODE_OUTSIDE           (0xC0000000Lu)
#define ADC_CMP_OFFSET                 (30u)

/* defines for _START_CTRL register */
#define ADC_FW_TRIGGER                 (0x00000001Lu)

/* defines for DFT_CTRL register */
#define ADC_DLY_INC                    (0x00000001Lu)
#define ADC_HIZ                        (0x00000002Lu)
#define ADC_DFT_INC_MASK               (0x000F0000Lu)
#define ADC_DFT_OUTC_MASK              (0x00700000Lu)
#define ADC_SEL_CSEL_DFT_MASK          (0x0F000000Lu)

/* configuration for clock speed > 9 Mhz based on
* characterization results
*/
#define ADC_SEL_CSEL_DFT_CHAR          (0x03000000Lu)
#define ADC_EN_CSEL_DFT                (0x10000000Lu)
#define ADC_DCEN                       (0x20000000Lu)
#define ADC_ADFT_OVERRIDE              (0x80000000Lu)

/* defines for CHAN_CONFIG / DIE_CHAN_CONFIG register
*  and channelsConfig parameter
*/
#define ADC_SARMUX_VIRT_SELECT         (0x00000070Lu)
#define ADC_DIFFERENTIAL_EN            (0x00000100Lu)
#define ADC_ALT_RESOLUTION_ON          (0x00000200Lu)
#define ADC_AVERAGING_EN               (0x00000400Lu)

#define ADC_SAMPLE_TIME_SEL_SHIFT      (12u)
#define ADC_SAMPLE_TIME_SEL_MASK       (0x00003000Lu)

#define ADC_CHANNEL_CONFIG_MASK        (0x00003700Lu)

/* for CHAN_CONFIG only */
#define ADC_DSI_OUT_EN                 (0x80000000Lu)

/* for INJ_CHAN_CONFIG only */
#define ADC_INJ_TAILGATING             (0x40000000Lu)
#define ADC_INJ_CHAN_EN                (0x80000000Lu)

/* defines for CHAN_WORK register */
#define ADC_SAR_WRK_MAX_12BIT          (0x00001000Lu)
#define ADC_SAR_WRK_MAX_10BIT          (0x00000400Lu)
#define ADC_SAR_WRK_MAX_8BIT           (0x00000100Lu)

/* defines for CHAN_RESULT register */
#define ADC_RESULT_MASK                (0x0000FFFFLu)
#define ADC_SATURATE_INTR_MIR          (0x20000000Lu)
#define ADC_RANGE_INTR_MIR             (0x40000000Lu)
#define ADC_CHAN_RESULT_VALID_MIR      (0x80000000Lu)

/* defines for INTR_MASK register */
#define ADC_EOS_MASK                   (0x00000001Lu)
#define ADC_OVERFLOW_MASK              (0x00000002Lu)
#define ADC_FW_COLLISION_MASK          (0x00000004Lu)
#define ADC_DSI_COLLISION_MASK         (0x00000008Lu)
#define ADC_INJ_EOC_MASK               (0x00000010Lu)
#define ADC_INJ_SATURATE_MASK          (0x00000020Lu)
#define ADC_INJ_RANGE_MASK             (0x00000040Lu)
#define ADC_INJ_COLLISION_MASK         (0x00000080Lu)

/* defines for INJ_RESULT register */
#define ADC_INJ_COLLISION_INTR_MIR     (0x10000000Lu)
#define ADC_INJ_SATURATE_INTR_MIR      (0x20000000Lu)
#define ADC_INJ_RANGE_INTR_MIR         (0x40000000Lu)
#define ADC_INJ_EOC_INTR_MIR           (0x80000000Lu)

/* defines for MUX_SWITCH0 register */
#define ADC_MUX_FW_VSSA_VMINUS         (0x00010000Lu)

/* defines for PUMP_CTRL register */
#define ADC_PUMP_CTRL_ENABLED          (0x80000000Lu)

/* additional defines for channelsConfig parameter */
#define ADC_IS_SATURATE_EN_MASK        (0x00000001Lu)
#define ADC_IS_RANGE_CTRL_EN_MASK      (0x00000002Lu)

/* defines for WOUNDING register */
#define ADC_WOUNDING_12BIT             (0x00000000Lu)
#define ADC_WOUNDING_10BIT             (0x00000001Lu)
#define ADC_WOUNDING_8BIT              (0x00000002Lu)

/* Trim value based on characterization */
#define ADC_TRIM_COEF                  (2u)

#if(ADC_MAX_RESOLUTION == ADC_RESOLUTION_10)
    #define ADC_ALT_WOUNDING           ADC_WOUNDING_10BIT
#else
    #define ADC_ALT_WOUNDING           ADC_WOUNDING_8BIT
#endif /* ADC_MAX_RESOLUTION == ADC_RESOLUTION_10 */

#if(ADC_DEFAULT_VREF_SEL == ADC__VDDA_2)
    #define ADC_DEFAULT_VREF_SOURCE    ADC_VREF_VDDA_2
#elif(ADC_DEFAULT_VREF_SEL == ADC__VDDA)
    #define ADC_DEFAULT_VREF_SOURCE    ADC_VREF_VDDA
#elif(ADC_DEFAULT_VREF_SEL == ADC__INTERNAL1024)
    #define ADC_DEFAULT_VREF_SOURCE    ADC_VREF_INTERNAL1024
#elif(ADC_DEFAULT_VREF_SEL == ADC__INTERNAL1024BYPASSED)
    #define ADC_DEFAULT_VREF_SOURCE    ADC_VREF_INTERNAL1024BYPASSED
#elif(ADC_DEFAULT_VREF_SEL == ADC__INTERNALVREF)
    #define ADC_DEFAULT_VREF_SOURCE    ADC_VREF_INTERNALVREF
#elif(ADC_DEFAULT_VREF_SEL == ADC__INTERNALVREFBYPASSED)
    #define ADC_DEFAULT_VREF_SOURCE    ADC_VREF_INTERNALVREFBYPASSED
#elif(ADC_DEFAULT_VREF_SEL == ADC__VDDA_2BYPASSED)
    #define ADC_DEFAULT_VREF_SOURCE    ADC_VREF_VDDA_2BYPASSED
#else
    #define ADC_DEFAULT_VREF_SOURCE    ADC_VREF_EXTERNAL
#endif /* ADC_DEFAULT_VREF_SEL == ADC__VDDA_2 */

#if(ADC_DEFAULT_NEG_INPUT_SEL == ADC__VSS)
    /* Connect NEG input of SARADC to VSSA close to the SARADC for single channel mode */
    #if(ADC_TOTAL_CHANNELS_NUM == 1u)
        #define ADC_DEFAULT_SE_NEG_INPUT    ADC_NEG_VSSA
    #else
        #define ADC_DEFAULT_SE_NEG_INPUT    ADC_NEG_VSSA_KELVIN
    #endif /* (ADC_TOTAL_CHANNELS_NUM == 1u) */
    /* Do not connect VSSA to VMINUS when one channel in differential mode used */
    #if((ADC_TOTAL_CHANNELS_NUM == 1u) && (ADC_CHANNELS_MODE != 0u))
        #define ADC_DEFAULT_MUX_SWITCH0     0u
    #else    /* miltiple channels or one single channel */
        #define ADC_DEFAULT_MUX_SWITCH0     ADC_MUX_FW_VSSA_VMINUS
    #endif /* (ADC_TOTAL_CHANNELS_NUM == 1u) */
#elif(ADC_DEFAULT_NEG_INPUT_SEL == ADC__VREF)
    /* Do not connect VNEG to VREF when one channel in differential mode used */
    #if((ADC_TOTAL_CHANNELS_NUM == 1u) && (ADC_CHANNELS_MODE != 0u))
        #define ADC_DEFAULT_SE_NEG_INPUT    0u
    #else    /* miltiple channels or one single channel */
        #define ADC_DEFAULT_SE_NEG_INPUT    ADC_NEG_VREF
    #endif /* (ADC_TOTAL_CHANNELS_NUM == 1u) */
    #define ADC_DEFAULT_MUX_SWITCH0     0u
#elif (ADC_SINGLE_PRESENT != 0u)
    #define ADC_DEFAULT_SE_NEG_INPUT    ADC_NEG_OTHER
    #define ADC_DEFAULT_MUX_SWITCH0     0u
#else
    #define ADC_DEFAULT_SE_NEG_INPUT    0u
    #define ADC_DEFAULT_MUX_SWITCH0     0u
#endif /* ADC_DEFAULT_NEG_INPUT_SEL == ADC__VREF */

/* If the SAR is configured for multiple channels, always set SAR_HW_CTRL_NEGVREF to 1 */
#if(ADC_TOTAL_CHANNELS_NUM == 1u)
    #define ADC_DEFAULT_HW_CTRL_NEGVREF 0u
#else
    #define ADC_DEFAULT_HW_CTRL_NEGVREF ADC_SAR_HW_CTRL_NEGVREF
#endif /* (ADC_TOTAL_CHANNELS_NUM == 1u) */


#if(ADC_DEFAULT_ALT_RESOLUTION_SEL == ADC__RES8)
    #define ADC_DEFAULT_ALT_RESOLUTION     (ADC_ALT_RESOLUTION_8BIT)
    #define ADC_DEFAULT_MAX_WRK_ALT        (ADC_SAR_WRK_MAX_8BIT)
#else
    #define ADC_DEFAULT_ALT_RESOLUTION     (ADC_ALT_RESOLUTION_10BIT)
    #define ADC_DEFAULT_MAX_WRK_ALT        (ADC_SAR_WRK_MAX_10BIT)
#endif /* End ADC_DEFAULT_ALT_RESOLUTION_SEL == ADC__RES8 */

#if(ADC_DEFAULT_JUSTIFICATION_SEL == ADC__RIGHT)
    #define ADC_DEFAULT_JUSTIFICATION  ADC_DATA_ALIGN_RIGHT
#else
    #define ADC_DEFAULT_JUSTIFICATION  ADC_DATA_ALIGN_LEFT
#endif /* ADC_DEFAULT_JUSTIFICATION_SEL == ADC__RIGHT */

#if(ADC_DEFAULT_DIFF_RESULT_FORMAT_SEL == ADC__FSIGNED)
    #define ADC_DEFAULT_DIFF_RESULT_FORMAT ADC_DIFF_SIGNED_RESULT
#else
    #define ADC_DEFAULT_DIFF_RESULT_FORMAT ADC_DIFF_UNSIGNED_RESULT
#endif /* ADC_DEFAULT_DIFF_RESULT_FORMAT_SEL == ADC__FSIGNED */

#if(ADC_DEFAULT_SE_RESULT_FORMAT_SEL == ADC__FSIGNED)
    #define ADC_DEFAULT_SE_RESULT_FORMAT ADC_SE_SIGNED_RESULT
#else
    #define ADC_DEFAULT_SE_RESULT_FORMAT ADC_SE_UNSIGNED_RESULT
#endif /* ADC_DEFAULT_SE_RESULT_FORMAT_SEL == ADC__FSIGNED */

#if(ADC_DEFAULT_SAMPLE_MODE_SEL == ADC__FREERUNNING)
    #define ADC_DSI_TRIGGER        0u
#else /* Firmware trigger */
    #define ADC_DSI_TRIGGER        (ADC_DSI_TRIGGER_EN | ADC_DSI_SYNC_TRIGGER)
#endif /* End ADC_DEFAULT_SAMPLE_MODE == ADC__FREERUNNING */

#if(ADC_INJ_CHANNEL_ENABLED)
    #define ADC_SAR_INTR_MASK      (ADC_EOS_MASK | ADC_INJ_EOC_MASK)
#else
    #define ADC_SAR_INTR_MASK      (ADC_EOS_MASK)
#endif /* ADC_INJ_CHANNEL_ENABLED*/

#if(ADC_DEFAULT_AVG_MODE == ADC__FIXEDRESOLUTION)
    #define ADC_AVG_SHIFT_MODE     ADC_AVG_SHIFT
#else
    #define ADC_AVG_SHIFT_MODE     0u
#endif /* End ADC_DEFAULT_AVG_MODE */

#define ADC_COMPARE_MODE           (uint32)((uint32)(ADC_DEFAULT_COMPARE_MODE) \
                                                << ADC_CMP_OFFSET)

#if(ADC_TOTAL_CHANNELS_NUM > 1u)
    #define ADC_DEFAULT_SWITCH_CONF    0u
#else /* Disable SAR sequencer from enabling routing switches in single channel mode */
    #define ADC_DEFAULT_SWITCH_CONF    ADC_SWITCH_DISABLE
#endif /* End ADC_TOTAL_CHANNELS_NUM > 1 */

#define ADC_DEFAULT_POWER \
       ((ADC_NOMINAL_CLOCK_FREQ > (ADC_MAX_FREQUENCY / 4)) ? ADC_NORMAL_PWR : \
       ((ADC_NOMINAL_CLOCK_FREQ > (ADC_MAX_FREQUENCY / 8)) ? ADC_HALF_PWR : \
                                                                                       ADC_QUARTER_PWR))

#define ADC_DEFAULT_CTRL_REG_CFG       (ADC_DEFAULT_VREF_SOURCE \
                                                   | ADC_DEFAULT_SE_NEG_INPUT \
                                                   | ADC_DEFAULT_HW_CTRL_NEGVREF \
                                                   | ADC_DEFAULT_POWER \
                                                   | ADC_DSI_SYNC_CONFIG \
                                                   | ADC_DEFAULT_SWITCH_CONF)

#define ADC_DEFAULT_SAMPLE_CTRL_REG_CFG (ADC_DEFAULT_DIFF_RESULT_FORMAT \
                                                    | ADC_DEFAULT_SE_RESULT_FORMAT \
                                                    | ADC_DEFAULT_JUSTIFICATION \
                                                    | ADC_DEFAULT_ALT_RESOLUTION \
                                           | (uint8)(ADC_DEFAULT_AVG_SAMPLES_NUM \
                                                   << ADC_AVG_CNT_OFFSET) \
                                                    | ADC_AVG_SHIFT_MODE \
                                                    | ADC_DSI_TRIGGER \
                                                    | ADC_EOS_DSI_OUT_EN)

#define ADC_DEFAULT_RANGE_THRES_REG_CFG (ADC_DEFAULT_LOW_LIMIT \
            | (uint32)((uint32)ADC_DEFAULT_HIGH_LIMIT << ADC_RANGE_HIGH_OFFSET))

#define ADC_DEFAULT_SAMPLE_TIME01_REG_CFG (ADC_DEFAULT_ACLKS_NUM \
            | (uint32)((uint32)ADC_DEFAULT_BCLKS_NUM << ADC_SAMPLE_TIME13_OFFSET))

#define ADC_DEFAULT_SAMPLE_TIME23_REG_CFG (ADC_DEFAULT_CCLKS_NUM \
            | (uint32)((uint32)ADC_DEFAULT_DCLKS_NUM << ADC_SAMPLE_TIME13_OFFSET))


#endif /* End CY_ADC_SAR_SEQ_ADC_H */


/* [] END OF FILE */
