akita11/BLE_PresenPointer/src/TPT02r.cydsn/codegentemp/ADC.c

/*******************************************************************************
* File Name: ADC.c
* Version 2.40
*
* Description:
*  This file provides the source code to the API for the Sequencing Successive
*  Approximation ADC Component Component.
*
* Note:
*
********************************************************************************
* Copyright 2008-2015, Cypress Semiconductor Corporation.  All rights reserved.
* You may use this file only in accordance with the license, terms, conditions,
* disclaimers, and limitations in the end user license agreement accompanying
* the software package with which this file was provided.
*******************************************************************************/

#include "ADC.h"


/***************************************
* Global data allocation
***************************************/
uint8 ADC_initVar = 0u;
volatile int16 ADC_offset[ADC_TOTAL_CHANNELS_NUM];
volatile int32 ADC_countsPer10Volt[ADC_TOTAL_CHANNELS_NUM];   /* Gain compensation */


/***************************************
* Local data allocation
***************************************/
/* Channels configuration generated by customiser */
static const uint32 CYCODE ADC_channelsConfig[] = { 0x00000400u };


/*******************************************************************************
* Function Name: ADC_Start
********************************************************************************
*
* Summary:
*  Performs all required initialization for this component
*  and enables the power. The power will be set to the appropriate
*  power based on the clock frequency.
*
* Parameters:
*  None.
*
* Return:
*  None.
*
* Global variables:
*  The ADC_initVar variable is used to indicate when/if initial
*  configuration of this component has happened. The variable is initialized to
*  zero and set to 1 the first time ADC_Start() is called. This allows for
*  component Re-Start without re-initialization in all subsequent calls to the
*  ADC_Start() routine.
*  If re-initialization of the component is required the variable should be set
*  to zero before call of ADC_Start() routine, or the user may call
*  ADC_Init() and ADC_Enable() as done in the
*  ADC_Start() routine.
*
*******************************************************************************/
void ADC_Start(void)
{
    /* If not Initialized then initialize all required hardware and software */
    if(ADC_initVar == 0u)
    {
        ADC_Init();
        ADC_initVar = 1u;
    }
    ADC_Enable();
}


/*******************************************************************************
* Function Name: ADC_Init
********************************************************************************
*
* Summary:
*  Initialize component's parameters to the parameters set by user in the
*  customizer of the component placed onto schematic. Usually called in
*  ADC_Start().
*
* Parameters:
*  None.
*
* Return:
*  None.
*
* Global variables:
*  The ADC_offset variable is initialized.
*
*******************************************************************************/
void ADC_Init(void)
{
    uint32 chNum;
    uint32 tmpRegVal;
    int32 counts;

    #if(ADC_TOTAL_CHANNELS_NUM > 1u)
        static const uint8 CYCODE ADC_InputsPlacement[] =
        {
            (uint8)(ADC_cy_psoc4_sarmux_8__CH_0_PORT << 4u) |
            (uint8)ADC_cy_psoc4_sarmux_8__CH_0_PIN
            ,(uint8)(ADC_cy_psoc4_sarmux_8__CH_1_PORT << 4u) |
             (uint8)ADC_cy_psoc4_sarmux_8__CH_1_PIN
            #if(ADC_TOTAL_CHANNELS_NUM > 2u)
                ,(uint8)(ADC_cy_psoc4_sarmux_8__CH_2_PORT << 4u) |
                 (uint8)ADC_cy_psoc4_sarmux_8__CH_2_PIN
            #endif /* End ADC_TOTAL_CHANNELS_NUM > 2u */
            #if(ADC_TOTAL_CHANNELS_NUM > 3u)
                ,(uint8)(ADC_cy_psoc4_sarmux_8__CH_3_PORT << 4u) |
                 (uint8)ADC_cy_psoc4_sarmux_8__CH_3_PIN
            #endif /* End ADC_TOTAL_CHANNELS_NUM > 3u */
            #if(ADC_TOTAL_CHANNELS_NUM > 4u)
                ,(uint8)(ADC_cy_psoc4_sarmux_8__CH_4_PORT << 4u) |
                 (uint8)ADC_cy_psoc4_sarmux_8__CH_4_PIN
            #endif /* End ADC_TOTAL_CHANNELS_NUM > 4u */
            #if(ADC_TOTAL_CHANNELS_NUM > 5u)
                ,(uint8)(ADC_cy_psoc4_sarmux_8__CH_5_PORT << 4u) |
                 (uint8)ADC_cy_psoc4_sarmux_8__CH_5_PIN
            #endif /* End ADC_TOTAL_CHANNELS_NUM > 5u */
            #if(ADC_TOTAL_CHANNELS_NUM > 6u)
                ,(uint8)(ADC_cy_psoc4_sarmux_8__CH_6_PORT << 4u) |
                 (uint8)ADC_cy_psoc4_sarmux_8__CH_6_PIN
            #endif /* End ADC_TOTAL_CHANNELS_NUM > 6u */
            #if(ADC_TOTAL_CHANNELS_NUM > 7u)
                ,(uint8)(ADC_cy_psoc4_sarmux_8__CH_7_PORT << 4u) |
                 (uint8)ADC_cy_psoc4_sarmux_8__CH_7_PIN
            #endif /* End ADC_TOTAL_CHANNELS_NUM > 7u */
            #if(ADC_TOTAL_CHANNELS_NUM > 8u)
                ,(uint8)(ADC_cy_psoc4_sarmux_8__CH_8_PORT << 4u) |
                 (uint8)ADC_cy_psoc4_sarmux_8__CH_8_PIN
            #endif /* End ADC_TOTAL_CHANNELS_NUM > 8u */
            #if(ADC_TOTAL_CHANNELS_NUM > 9u)
                ,(uint8)(ADC_cy_psoc4_sarmux_8__CH_9_PORT << 4u) |
                 (uint8)ADC_cy_psoc4_sarmux_8__CH_9_PIN
            #endif /* End ADC_TOTAL_CHANNELS_NUM > 9u */
            #if(ADC_TOTAL_CHANNELS_NUM > 10u)
                ,(uint8)(ADC_cy_psoc4_sarmux_8__CH_10_PORT << 4u) |
                 (uint8)ADC_cy_psoc4_sarmux_8__CH_10_PIN
            #endif /* End ADC_TOTAL_CHANNELS_NUM > 10u */
            #if(ADC_TOTAL_CHANNELS_NUM > 11u)
                ,(uint8)(ADC_cy_psoc4_sarmux_8__CH_11_PORT << 4u) |
                 (uint8)ADC_cy_psoc4_sarmux_8__CH_11_PIN
            #endif /* End ADC_TOTAL_CHANNELS_NUM > 11u */
            #if(ADC_TOTAL_CHANNELS_NUM > 12u)
                ,(uint8)(ADC_cy_psoc4_sarmux_8__CH_12_PORT << 4u) |
                 (uint8)ADC_cy_psoc4_sarmux_8__CH_12_PIN
            #endif /* End ADC_TOTAL_CHANNELS_NUM > 12u */
            #if(ADC_TOTAL_CHANNELS_NUM > 13u)
                ,(uint8)(ADC_cy_psoc4_sarmux_8__CH_13_PORT << 4u) |
                 (uint8)ADC_cy_psoc4_sarmux_8__CH_13_PIN
            #endif /* End ADC_TOTAL_CHANNELS_NUM > 13u */
            #if(ADC_TOTAL_CHANNELS_NUM > 14u)
                ,(uint8)(ADC_cy_psoc4_sarmux_8__CH_14_PORT << 4u) |
                 (uint8)ADC_cy_psoc4_sarmux_8__CH_14_PIN
            #endif /* End ADC_TOTAL_CHANNELS_NUM > 14u */
            #if(ADC_TOTAL_CHANNELS_NUM > 15u)
                ,(uint8)(ADC_cy_psoc4_sarmux_8__CH_15_PORT << 4u) |
                 (uint8)ADC_cy_psoc4_sarmux_8__CH_15_PIN
            #endif /* End ADC_TOTAL_CHANNELS_NUM > 15u */
            #if(ADC_TOTAL_CHANNELS_NUM > 16u)
                ,(uint8)(ADC_cy_psoc4_sarmux_8__CH_16_PORT << 4u) |
                 (uint8)ADC_cy_psoc4_sarmux_8__CH_16_PIN
            #endif /* End ADC_TOTAL_CHANNELS_NUM > 16u */
        };
    #endif /* End ADC_TOTAL_CHANNELS_NUM > 1u */

    #if(ADC_IRQ_REMOVE == 0u)
        /* Start and set interrupt vector */
        CyIntSetPriority(ADC_INTC_NUMBER, ADC_INTC_PRIOR_NUMBER);
        (void)CyIntSetVector(ADC_INTC_NUMBER, &ADC_ISR);
    #endif   /* End ADC_IRQ_REMOVE */

    /* Init SAR and MUX registers */
    ADC_SAR_CHAN_EN_REG = ADC_DEFAULT_EN_CHANNELS;
    ADC_SAR_CTRL_REG |= ADC_DEFAULT_CTRL_REG_CFG | 
        /* Enable the SAR internal pump when global pump is enabled */
        (((ADC_PUMP_CTRL_REG & ADC_PUMP_CTRL_ENABLED) != 0u) ? 
        ADC_BOOSTPUMP_EN : 0u);
    ADC_SAR_SAMPLE_CTRL_REG = ADC_DEFAULT_SAMPLE_CTRL_REG_CFG;
    ADC_SAR_RANGE_THRES_REG = ADC_DEFAULT_RANGE_THRES_REG_CFG;
    ADC_SAR_RANGE_COND_REG  = ADC_COMPARE_MODE;
    ADC_SAR_SAMPLE_TIME01_REG = ADC_DEFAULT_SAMPLE_TIME01_REG_CFG;
    ADC_SAR_SAMPLE_TIME23_REG = ADC_DEFAULT_SAMPLE_TIME23_REG_CFG;
    
    /* Connect Vm to VSSA when even one channel is single-ended or multiple channels configured */
    #if(ADC_DEFAULT_MUX_SWITCH0 != 0u)
        ADC_MUX_SWITCH0_REG |= ADC_DEFAULT_MUX_SWITCH0;
        /* Set MUX_HW_CTRL_VSSA in MUX_SWITCH_HW_CTRL when multiple channels enabled */
        #if(ADC_TOTAL_CHANNELS_NUM > 1u)
            ADC_MUX_SWITCH_HW_CTRL_REG |= ADC_DEFAULT_MUX_SWITCH0;
        #endif /* ADC_TOTAL_CHANNELS_NUM > 1u */
    #endif /*ADC_CHANNELS_MODE !=0 */

    ADC_SAR_SATURATE_INTR_MASK_REG = 0u;
    ADC_SAR_RANGE_INTR_MASK_REG = 0u;
    ADC_SAR_INTR_MASK_REG = ADC_SAR_INTR_MASK;

    #if(ADC_CY_SAR_IP_VER == ADC_CY_SAR_IP_VER0)
        ADC_ANA_TRIM_REG = ADC_TRIM_COEF;
    #endif /* (ADC_CY_SAR_IP_VER == ADC_CY_SAR_IP_VER0) */

    /* Read and modify default configuration based on characterization */
    tmpRegVal = ADC_SAR_DFT_CTRL_REG;
    tmpRegVal &= (uint32)~ADC_DCEN;
    
    #if(ADC_CY_SAR_IP_VER == ADC_CY_SAR_IP_VER0)
        #if(ADC_NOMINAL_CLOCK_FREQ > (ADC_MAX_FREQUENCY / 2))
            tmpRegVal |= ADC_SEL_CSEL_DFT_CHAR;
        #else  /* clock speed < 9 Mhz */
            tmpRegVal |= ADC_DLY_INC;
        #endif /* clock speed > 9 Mhz */
    #else
        #if ((ADC_DEFAULT_VREF_SEL == ADC__INTERNAL1024) || \
             (ADC_DEFAULT_VREF_SEL == ADC__INTERNALVREF))
            tmpRegVal |= ADC_DLY_INC;
        #else
            tmpRegVal |= ADC_DCEN;
            tmpRegVal &= (uint32)~ADC_DLY_INC;
        #endif /* ((ADC_DEFAULT_VREF_SEL == ADC__INTERNAL1024) || \
                   (ADC_DEFAULT_VREF_SEL == ADC__INTERNALVREF)) */
    #endif /* (ADC_CY_SAR_IP_VER == ADC_CY_SAR_IP_VER0) */
    
    ADC_SAR_DFT_CTRL_REG = tmpRegVal;

    #if(ADC_MAX_RESOLUTION != ADC_RESOLUTION_12)
        ADC_WOUNDING_REG = ADC_ALT_WOUNDING;
    #endif /* ADC_MAX_RESOLUTION != ADC_RESOLUTION_12 */

    for(chNum = 0u; chNum < ADC_TOTAL_CHANNELS_NUM; chNum++)
    {
        tmpRegVal = (ADC_channelsConfig[chNum] & ADC_CHANNEL_CONFIG_MASK);
        #if(ADC_TOTAL_CHANNELS_NUM > 1u)
            tmpRegVal |= ADC_InputsPlacement[chNum];
        #endif /* End ADC_TOTAL_CHANNELS_NUM > 1u */
        
        
        /* When the part is limited to 10-bit then the SUB_RESOLUTION bit
        *  will be ignored and the RESOLUTION bit selects between 10-bit
        *  (0) and 8-bit (1) resolution.
        */
        #if((ADC_MAX_RESOLUTION != ADC_RESOLUTION_12) && \
            (ADC_ALT_WOUNDING == ADC_WOUNDING_10BIT))
            tmpRegVal &= (uint32)(~ADC_ALT_RESOLUTION_ON);
        #endif /* ADC_MAX_RESOLUTION != ADC_RESOLUTION_12 */

        #if(ADC_INJ_CHANNEL_ENABLED)
        if(chNum < ADC_SEQUENCED_CHANNELS_NUM)
        #endif /* ADC_INJ_CHANNEL_ENABLED */
        {
            CY_SET_REG32((reg32 *)(ADC_SAR_CHAN_CONFIG_IND + (uint32)(chNum << 2)), tmpRegVal);

            if((ADC_channelsConfig[chNum] & ADC_IS_SATURATE_EN_MASK) != 0u)
            {
                ADC_SAR_SATURATE_INTR_MASK_REG |= (uint16)((uint16)1 << chNum);
            }

            if((ADC_channelsConfig[chNum] & ADC_IS_RANGE_CTRL_EN_MASK) != 0u)
            {
                ADC_SAR_RANGE_INTR_MASK_REG |= (uint16)((uint16)1 << chNum);
            }
        }
        #if(ADC_INJ_CHANNEL_ENABLED)
            else
            {
                CY_SET_REG32(ADC_SAR_INJ_CHAN_CONFIG_PTR, tmpRegVal | ADC_INJ_TAILGATING);

                if((ADC_channelsConfig[chNum] & ADC_IS_SATURATE_EN_MASK) != 0u)
                {
                    ADC_SAR_INTR_MASK_REG |= ADC_INJ_SATURATE_MASK;
                }

                if((ADC_channelsConfig[chNum] & ADC_IS_RANGE_CTRL_EN_MASK) != 0u)
                {
                    ADC_SAR_INTR_MASK_REG |= ADC_INJ_RANGE_MASK;
                }
            }
        #endif /* ADC_INJ_CHANNEL_ENABLED */

        if((ADC_channelsConfig[chNum] & ADC_ALT_RESOLUTION_ON) != 0u)
        {
               counts = (int32)ADC_DEFAULT_MAX_WRK_ALT;
        }
        else
        {
               counts = (int32)ADC_SAR_WRK_MAX_12BIT;
        }

        if((ADC_channelsConfig[chNum] & ADC_DIFFERENTIAL_EN) == 0u)
        {
            #if((ADC_DEFAULT_SE_RESULT_FORMAT_SEL == ADC__FSIGNED) && \
                (ADC_DEFAULT_NEG_INPUT_SEL == ADC__VREF))
                /* Set offset to the minus half scale to convert results to unsigned format */
                ADC_offset[chNum] = (int16)(counts / -2);
            #else
                ADC_offset[chNum] = 0;
            #endif /* end DEFAULT_SE_RESULT_FORMAT_SEL == ADC__FSIGNED */
        }
        else    /* Differential channel */
        {
            #if(ADC_DEFAULT_DIFF_RESULT_FORMAT_SEL == ADC__FUNSIGNED)
                /* Set offset to the half scale to convert results to signed format */
                ADC_offset[chNum] = (int16)(counts / 2);
            #else
                ADC_offset[chNum] = 0;
            #endif /* end ADC_DEFAULT_DIFF_RESULT_FORMAT_SEL == ADC__FUNSIGNED */
        }
        /* Calculate gain in counts per 10 volts with rounding */
        ADC_countsPer10Volt[chNum] = (int16)(((counts * ADC_10MV_COUNTS) +
                            ADC_DEFAULT_VREF_MV_VALUE) / (ADC_DEFAULT_VREF_MV_VALUE * 2));
    }
}

/*******************************************************************************
* Function Name: ADC_SAR_1_Enable
********************************************************************************
*
* Summary:
*  Enables the clock and analog power for SAR ADC.
*
* Parameters:
*  None.
*
* Return:
*  None.
*
*******************************************************************************/
void ADC_Enable(void)
{
    if (0u == (ADC_SAR_CTRL_REG & ADC_ENABLE))
    {
        #if(ADC_CY_SAR_IP_VER != ADC_CY_SAR_IP_VER0)

            while (0u != (ADC_SAR_STATUS_REG & ADC_STATUS_BUSY))
            {
                /* wait for SAR to go idle to avoid deadlock */
            }
        #endif /* (ADC_CY_SAR_IP_VER != ADC_CY_SAR_IP_VER0) */
        
        ADC_SAR_CTRL_REG |= ADC_ENABLE;
        
        /* The block is ready to use 10 us after the enable signal is set high. */
        CyDelayUs(ADC_10US_DELAY);         
    }
}


/*******************************************************************************
* Function Name: ADC_Stop
********************************************************************************
*
* Summary:
*  This function stops ADC conversions and puts the ADC into its lowest power
*  mode.
*
* Parameters:
*  None.
*
* Return:
*  None.
*
*******************************************************************************/
void ADC_Stop(void)
{
    ADC_SAR_CTRL_REG &= (uint32)~ADC_ENABLE;
}


/*******************************************************************************
* Function Name: ADC_StartConvert
********************************************************************************
*
* Summary:
*  Description:
*  For free running mode, this API starts the conversion process and it
*  runs continuously.
*
*  In a triggered mode, this routine triggers every conversion by
*  writing into the FW_TRIGGER bit in SAR_START_CTRL reg. In triggered mode,
*  every conversion has to start by this API.
*
* Parameters:
*  None.
*
* Return:
*  None.
*
*******************************************************************************/
void ADC_StartConvert(void)
{
    #if(ADC_DEFAULT_SAMPLE_MODE_SEL == ADC__FREERUNNING)
        ADC_SAR_SAMPLE_CTRL_REG |= ADC_CONTINUOUS_EN;
    #else /* Firmware trigger */
        ADC_SAR_START_CTRL_REG = ADC_FW_TRIGGER;
    #endif /* End ADC_DEFAULT_SAMPLE_MODE == ADC__FREERUNNING */

}


/*******************************************************************************
* Function Name: ADC_StopConvert
********************************************************************************
*
* Summary:
*  Forces the ADC to stop all conversions.
*
* Parameters:
*  None.
*
* Return:
*  None.
*
*******************************************************************************/
void ADC_StopConvert(void)
{
    #if(ADC_DEFAULT_SAMPLE_MODE_SEL == ADC__FREERUNNING)
        ADC_SAR_SAMPLE_CTRL_REG &= (uint32)(~ADC_CONTINUOUS_EN);
    #endif /* ADC_DEFAULT_SAMPLE_MODE == ADC__FREERUNNING */
}


/*******************************************************************************
* Function Name: ADC_IsEndConversion
********************************************************************************
*
* Summary:
*  Description: Checks for ADC end of conversion for the case one
*  channel and end of scan for the case of multiple channels. It acts
*  as a software version of the EOC. This function provides the
*  programmer with two options. In one mode this function
*  immediately returns with the conversion status. In the other mode,
*  the function does not return (blocking) until the conversion has
*  completed.
*
* Parameters:
*  ADC_RETURN_STATUS        -> Immediately returns conversion result status
*  ADC_WAIT_FOR_RESULT      -> Does not return until ADC complete
*  ADC_RETURN_STATUS_INJ    -> Immediately returns conversion result status
*                              for injection channel
*  ADC_WAIT_FOR_RESULT_INJ  -> Does not return until ADC completes injection
*                              channel conversion
*
* Return:
*  If a non-zero value is returned, the last conversion or scan has completed.
*  If the returned value is zero, the ADC is still in the process of a scan.
*
*******************************************************************************/
uint32 ADC_IsEndConversion(uint32 retMode)
{
    uint32 status = 0u;

    if((retMode & (ADC_RETURN_STATUS | ADC_WAIT_FOR_RESULT)) != 0u)
    {
        do
        {
            status = ADC_SAR_INTR_REG & ADC_EOS_MASK;
        }while((status == 0u) && ((retMode & ADC_WAIT_FOR_RESULT) != 0u));

        if(status != 0u)
        {
            /* Clear EOS bit */
            ADC_SAR_INTR_REG = ADC_EOS_MASK;
        }
    }

    #if(ADC_INJ_CHANNEL_ENABLED)
        if((retMode & (ADC_RETURN_STATUS_INJ | ADC_WAIT_FOR_RESULT_INJ)) != 0u)
        {
            do
            {
                status |= ADC_SAR_INTR_REG & ADC_INJ_EOC_MASK;
            }while(((status & ADC_INJ_EOC_MASK) == 0u) &&
                   ((retMode & ADC_WAIT_FOR_RESULT_INJ) != 0u));

            if((status & ADC_INJ_EOC_MASK) != 0u)
            {
                /* Clear Injection EOS bit */
                ADC_SAR_INTR_REG = ADC_INJ_EOC_MASK;
            }
        }
    #endif /* ADC_INJ_CHANNEL_ENABLED */

    return (status);
}


/*******************************************************************************
* Function Name: ADC_GetResult16
********************************************************************************
*
* Summary:
*  Gets the data available in the SAR DATA register.
*
* Parameters:
*  chan: The ADC channel in which to return the result. The first channel
*  is 0 and the injection channel if enabled is the number of valid channels.
*
* Return:
*  Returns converted data as a signed 16-bit integer
*
*******************************************************************************/
int16 ADC_GetResult16(uint32 chan)
{
    uint32 result;

    /* Halt CPU in debug mode if channel is out of valid range */
    CYASSERT(chan < ADC_TOTAL_CHANNELS_NUM);

    if(chan < ADC_SEQUENCED_CHANNELS_NUM)
    {
        result = CY_GET_REG32((reg32 *)(ADC_SAR_CHAN_RESULT_IND + (uint32)(chan << 2u))) &
                ADC_RESULT_MASK;
    }
    else
    {
        #if(ADC_INJ_CHANNEL_ENABLED)
            result = ADC_SAR_INJ_RESULT_REG & ADC_RESULT_MASK;
        #else
            result = 0u;
        #endif /* ADC_INJ_CHANNEL_ENABLED */
    }

    return ( (int16)result );
}


/*******************************************************************************
* Function Name: ADC_SetChanMask
********************************************************************************
*
* Summary:
*  Sets the channel enable mask.
*
* Parameters:
*  mask: Sets which channels that will be
*  scanned. Setting bits for channels that do not exist will have no
*  effect. For example, if only 6 channels were enabled, setting a
*  mask of 0x0103 would only enable the last two channels (0 and 1).
*  This API will not enable the injection channel.
*  Examples: If the component is setup to sequence through 8
*  channels, a mask of 0x000F would enable channels 0, 1, 2, and 3.
*
* Return:
*  None.
*
*******************************************************************************/
void ADC_SetChanMask(uint32 mask)
{
    ADC_SAR_CHAN_EN_REG = mask & ADC_MAX_CHANNELS_EN_MASK;
}

#if(ADC_INJ_CHANNEL_ENABLED)


    /*******************************************************************************
    * Function Name: ADC_EnableInjection
    ********************************************************************************
    *
    * Summary:
    *  Enables the injection channel for the next scan only.
    *
    * Parameters:
    *  None.
    *
    * Return:
    *  None.
    *
    *******************************************************************************/
    void ADC_EnableInjection(void)
    {
        ADC_SAR_INJ_CHAN_CONFIG_REG |= ADC_INJ_CHAN_EN;
    }

#endif /* ADC_INJ_CHANNEL_ENABLED */


/*******************************************************************************
* Function Name: ADC_SetLowLimit
********************************************************************************
*
* Summary:
*  Sets the low limit parameter for a limit condition.
*
* Parameters:
*  lowLimit: The low limit for a limit condition.
*
* Return:
*  None.
*
*******************************************************************************/
void ADC_SetLowLimit(uint32 lowLimit)
{
    ADC_SAR_RANGE_THRES_REG &= (uint32)(~ADC_RANGE_LOW_MASK);
    ADC_SAR_RANGE_THRES_REG |= lowLimit & ADC_RANGE_LOW_MASK;
}


/*******************************************************************************
* Function Name: ADC_SetHighLimit
********************************************************************************
*
* Summary:
*  Sets the low limit parameter for a limit condition.
*
* Parameters:
*  highLimit: The high limit for a limit condition.
*
* Return:
*  None.
*
*******************************************************************************/
void ADC_SetHighLimit(uint32 highLimit)
{
    ADC_SAR_RANGE_THRES_REG &= (uint32)(~ADC_RANGE_HIGH_MASK);
    ADC_SAR_RANGE_THRES_REG |= (uint32)(highLimit << ADC_RANGE_HIGH_OFFSET);
}


/*******************************************************************************
* Function Name: ADC_SetLimitMask
********************************************************************************
*
* Summary:
*  Sets the channel limit condition mask.
*
* Parameters:
*  mask: Sets which channels that may cause a
*  limit condition interrupt. Setting bits for channels that do not exist
*  will have no effect. For example, if only 6 channels were enabled,
*  setting a mask of 0x0103 would only enable the last two channels (0 and 1).
*
* Return:
*  None.
*
*******************************************************************************/
void ADC_SetLimitMask(uint32 mask)
{
    ADC_SAR_RANGE_INTR_MASK_REG = mask & ADC_MAX_CHANNELS_EN_MASK;
}


/*******************************************************************************
* Function Name: ADC_SetSatMask
********************************************************************************
*
* Summary:
*  Sets the channel saturation event mask.
*
* Parameters:
*  mask: Sets which channels that may cause a
*  saturation event interrupt. Setting bits for channels that do not exist
*  will have no effect. For example, if only 8 channels were enabled,
*  setting a mask of 0x01C0 would only enable two channels (6 and 7).
*
* Return:
*  None.
*
*******************************************************************************/
void ADC_SetSatMask(uint32 mask)
{
    ADC_SAR_SATURATE_INTR_MASK_REG = mask & ADC_MAX_CHANNELS_EN_MASK;
}


/*******************************************************************************
* Function Name: ADC_SetOffset
********************************************************************************
*
* Summary:
*   Description: Sets the ADC offset which is used by the functions
*   ADC_CountsTo_uVolts, ADC_CountsTo_mVolts and ADC_CountsTo_Volts
*   to substract the offset from the given reading
*   before calculating the voltage conversion.
*
* Parameters:
*  chan: ADC channel number.
*  offset: This value is a measured value when the
*          inputs are shorted or connected to the same input voltage.
*
* Return:
*  None.
*
* Global variables:
*  ADC_Offset:  Modified to set the user provided offset.
*
*******************************************************************************/
void ADC_SetOffset(uint32 chan, int16 offset)
{
    /* Halt CPU in debug mode if channel is out of valid range */
    CYASSERT(chan < ADC_TOTAL_CHANNELS_NUM);

    ADC_offset[chan] = offset;
}


/*******************************************************************************
* Function Name: ADC_SetGain
********************************************************************************
*
* Summary:
*  Description: Sets the ADC gain in counts per 10 volt for the voltage
*  conversion functions below. This value is set by default by the
*  reference and input range settings. It should only be used to further
*  calibrate the ADC with a known input or if an external reference is
*  used. Affects the ADC_CountsTo_uVolts, ADC_CountsTo_mVolts
*  and ADC_CountsTo_Volts functions by supplying the correct
*  conversion between ADC counts and voltage.
*
* Parameters:
*  chan: ADC channel number.
*  adcGain: ADC gain in counts per 10 volts.
*
* Return:
*  None.
*
* Global variables:
*  ADC_CountsPer10Volt:  modified to set the ADC gain in counts
*   per 10 volt.
*
*******************************************************************************/
void ADC_SetGain(uint32 chan, int32 adcGain)
{
    /* Halt CPU in debug mode if channel is out of valid range */
    CYASSERT(chan < ADC_TOTAL_CHANNELS_NUM);

    ADC_countsPer10Volt[chan] = adcGain;
}
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
