akita11/BLE_PresenPointer/(commit log)

2016-12-22 modified switch handling based on original HID-Keyboard sample
    [TPT02-tcream.dxf, TPT02.brd, TPT02.sch, TPT02.sdf]
2016-12-22 スイッチの扱いをHID-Keyboardサンプルにならって修正。基板でバッテリ電圧を測定できるように修正。
    [TPT02-tcream.dxf, TPT02.brd, TPT02.sch, TPT02.sdf, TPT02_old.sdf]
2016-12-23 基板の修正（バッテリ電圧計測＆TXD端子）
    [TPT02.brd, TPT02.sch, TPT02_old.sdf]
2016-12-23 両脇のスイッチ(SWB/SWO)のパッケージを変更
    [TPT02.brd, TPT02.sch]
2016-12-26 CYBLE014008 version (TPT02r) board & source
    [TPT02_tentative.brd, TPT02_tentative.sch, TPT02r.brd, TPT02r.sch, TPT02r.sdf]
2017-01-04 電源をブーストDC/DCに変更。スイッチサイズ、基板サイズの調整。
    [TPT02rr.brd, TPT02rr.sch]
2017-01-04 Cの部品番号を整理。Elecrow向けBOMを作成。
    [TPT02rr.brd, TPT02rr.sch, TPT02rr_BOM.xlsx]
2017-01-08 部品の位置の微調整。
    [TPT02rrr-tcream.dxf, TPT02rrr.brd, TPT02rrr.sch, TPT02rrr_BOM.xlsx]
2017-01-10 両側のタクトスイッチのGND端子が基板端にかかるため削除
    [TPT02rrrr.brd, TPT02rrrr.sch, TPT02rrrr_BOM.xlsx]
2017-01-19 表面ソルダーマスクの追加
    [TPT02rrrr-tcream.dxf]
2017-01-29 部品位置の微調整。ソースの微調整（コネクト時にLED点滅）。
    [TPT02.sdf, TPT02r.sdf, TPT02rrrr_BOM.xlsx, TPT02rrrrr.brd, TPT02rrrrr.sch, TPT02rrrrr_BOM.xlsx]
2017-01-30 基板外径・シルクの微調整
    [TPT02rrrrr.brd]
2017-01-30 バッテリレベルを通知しないように変更。
    [TPT02r.sdf]
2017-01-30 バッテリ情報を通知しないように変更。
2017-02-05 TELEC認証に関するファイルの追加。
2017-02-20 無操作10分でhibernate、ボタン操作時にLEDフラッシュ。
    [TPT02r.sdf]
2017-02-23 Stopからでも復帰できるようにIDスイッチをP2.2に接続
    [TPT02rrrrr-tcream.dxf, TPT02rrrrrr.brd, TPT02rrrrrr.sch]
2017-02-27 BLEモジュールのハンダマスクを少し小さく修正
    [TPT02rrrrrrr-tcream.dxf, TPT02rrrrrrr.brd, TPT02rrrrrrr.sch]
2017-04-11 ファイルの整理、readmeの追加、組み立てマニュアルの追加
    [BLE_PP.brd, BLE_PP.sch, BLE_PP_BOM.xlsx, TPT02-tcream.dxf, TPT02.brd, TPT02.sch, TPT02_tentative.brd, TPT02_tentative.sch]
2017-04-11 ファイルの整理
    [TPT02est.xlsx]
2017-04-14 マニュアルの追記
2017-04-15 マニュアルの修正(消費電流についての記述を追加）
    [TPT02r.sdf]
2017-04-15 マニュアル（製品同梱ダイジェスト版）の追加
2017-04-16 ConnectionIntervalの最小・最大値を変更(7.5/15→30/60)。履歴基板データの整理。マニュアルの消費電流記述の変更。
    [BLE_PP_v15.brd, BLE_PP_v15.sch, BLE_PP_v15_BOM.xlsx, BLE_PP_v16.brd, BLE_PP_v16.sch, TPT02_v11.brd, TPT02_v11.sch, TPT02_v12.brd]
2017-04-19 ソースコードの修正（消費電力低減）、それにともなうマニュアルの修正。
    [TPT02r.sdf]
2017-04-19 ソースコード修正（スリープ時間を30分に、キーコードをPageUp/Downに）。マニュアルの修正。
    [TPT02r.sdf]
2017-04-21 スリープに入るアルゴリズム＆L2CAP paramUpdateRequestを送るアルゴリズムを変更。SleepからIDボタンで復帰。マニュアルの修正。
    [BLE_PP_v16.brd, BLE_PP_v16.sch, Hibernate_PSoC4_Example01.sdf, TPT02r.sdf]
2017-04-21 ソースコードの調整
    [Hibernate_PSoC4_Example01.sdf, TPT02r.sdf]
2017-04-24 v1.6のBOMを追加
    [BLE_PP_v16_BOM.xlsx]
